GusHMeza/Tandem/README.md

# Tandem
**Xilinx ZYNQ 7000 based compute module**
Work in progress 🛠

_As the final deliverable to complete FEDEVEL: High Speed Digital Hardware Design course by instructor Phil Salmony._

Since form factor was free to chose, I picked 150x100 mm or less as a target based on a rough estimate of how big of a rectangle could fit all the components and went from there. Next, worked my way through layout with rough calculations to get a sense of interconnect length and layer distribution and finally refined the design based on detailed calculations and simulation work. 

**Compute power**

Xilinx Zynq 7000 series SoC, Part Number: 

**Comunications & Networking:**

1 X Gigabit Ethernet

1 X USB 2.0 (USB On-the-go compatible)

**Configuration**

1 X JTAG interface

**Memory**

2 X DDR Gen 3 low power (16-bit wide data bus) components

1 X 8 Gb of eMMC component

**Power** 

10W (5V) power supply

**Expansion connectors**

2 X Mezzanine connectors (break out some I/O from the Zynq 7000)

Front



Back



# Signal Integrity

**Target interconnects & requirements**

The PCB deisgn is mainly driven by the DDR Gen 3 single-ended signals and differential clocks as they have have the highest speed requirements. The selected stackup shall also accomodate a Gigabit Ethernet transciever, with 1 GHz differencial signaling, and a USB PHY close to the SoC.

| Timing Parameters |  |
| --- | --- |
| Transfer rate | 1886 MT/s |
| Clock rate | 0.9 GHz |
| Signal period | 1ns period |

| DDR drivers | | |
| --- | --- | --- |
| Static discipline | Unit/note ||
| VTT | 0.675 |V|
| Vih(ac) | 135 mV |above VTT|
| Vil(ac) | -135 mV |below VTT|
| --- | --- | --- |
| Specification | Unit ||
| C @ 1 GHz | 2 |pF|
| Over/under shoot | 0.1 |V/ns|
| Single ended slew rate max | 5 |V/ns|

| Driver output impedance | | |
| --- | --- | --- |
| Zo | Unit |Note|
| 34.3 | Ohms |Default|
| 40 | Ohms |Alternate|

**Stackup selection**

The standard 10L PCB build-up from PCB way was selected, as their overall pricing is cheap and their capabilities seem sufficient using their 'low difficulty to manufacture' specifications.



The layer assignment goes as below, and the expected characteristic impedances obtained from it were calculated using a spreadsheet and the formulae from Hall S., Hall G. and McCall J., High Speed Digital System Design, 2001, Wiley.

Layer assignment considers the DDR control signals are routed more towards the back side of the board as termination resitors are placed on the back side of the board and this layer assignment offers a logical channel architecture. The control signals are intended to have a GND plane above and below to maximize SI. 

DDR data signals are routed on the top layer to obtain faster propagation due to having no dielectric material above, as well as to allocate them sufficient space for them to fan out as needed. Routing DDR data and DDR control lines on the same layer seemed impractical as they are difficul to fan out given the current pin assignment on the CLG400 package.
  


**Loss characterization**

Two package models were developed for the Zynq 7000, one considering a generic 25 um Au wire bond on a worst case length for the 17x17mm package and another one considering 90um C4 bumps with a package via in series. An online calculator was used to approximate RLC values for these structures, and the channel was simulated in SPICE software that offest S-parameter visualization (QUCS).

1st package model (generic wire-bond package technology)



2nd package model (C4 bumps used on higher speed packages)



_Conclusion_

-For the frequency of interest for the DDR interface (1 GHz) it is not feasible to typicall wire bond technology, as it causes that the majority of the signal's energy content is reflected back to the source at the frequency of interest. 

-Assuming the Zynq 7000's package uses C4 bumps, the SPICE simulation that considers the C4 bump in series with a package via, one fan out via, the PCB trace and one last connection via shows that insertion loss is -0.498 dB and return loss is -9.659 dB.

To verify if this is a feasible design, the loss budget is calculated below.

| Loss budget | | |
| --- | --- | --- |
| Value | Unit |Note|
| 0.675 | V |VTT|
| 0.135 | V (above VTT) |Vhigh|
| 0.81 | V |Vhigh|
| 0.54 | V |Vdd-Vhigh = V_loss margin|
| -0.9691 | dB |10*log10(V_loss margin / VTT)|

On DDR the voltage fluctutates between VTT and either rail. For a HIGH bit, the voltage will fluctuate from VTT to VDD, and has to cross Vhigh (ac) specified on the data sheet for it to be on the right amplitude. Therefore, the margin between 0.81 V (VTT + 135mV) and VDD is 0.54 V. This is considered to be the loss margin, which relative to VTT (which is VDD/2) is -0.9691 dB.

Per the calculations above, singal loss @ 1 GHz is of -0.498 dB and is within the loss budget of -0.9691 dB. Assuming the IC package uses C4 bumps type packaging and the cylindrical wire model is accurate (as a solder ball after reflow becomes a truncated sphere on both sides), the singl ended channel design is feasible to transmit the DDR single ended signals. 

**Crosstalk estimations**

To account for routing density, the potential crosstalk on the traces was evaluated using the provided IBIS models for the Zynq 7000 on Xilinx's website and a series of circuit models created to simulate cross talk and cross talk induced time delays.

This is work in progress...









# Layout

DDR data signals on L1



DDR control signals on layers 6, 8 and 10.







# Signal Integrity Test Vehicles (SITV)

This project moivated me to create an SITV design to test different materials for stackups and common copper structures found in Tandem with a VNA up to the GHz range. I have a nano VNA on hand which can measure up to 1.5 GHz which is barely enough for the purpose of meausuring performance at the DDR fudamental frequency. Version 1 of the SITV was designed to cover the test cases below. All of the structures are non-impedance-controlled and are the minimum size copper features offered by JLCPCB.

| Test cases | | |
| --- | --- | --- |
| Description | Results |P/F|
| Insertion loss of a 30 mm straight trace | dB | TBD |
| Delta L test to measure loss purely due to the PCB trace | dB/in | TBD |
| Via transitions: compare loss between 1 transition and 2 transitions | dB | TBD |
| Crosstalk test, spacing 1: compare voltage amplitude on the victim trace at different trace spacings | dB @ f _ spacing 1 | TBD |
| Crosstalk test, spacing 2 | dB @ f _ spacing 2 | TBD |
| Straight trace insertion loss vs skewed trace insertion loss | dB @ 1° and 5° skew | TBD |

Work in progress...



For instance, this picture below shows that this non-impedance-controlled structure causes -2.7 dB of loss at 450 MHz and above 600 MHz there is more energy being reflected back to source than proagating through it. Therefore, for a loss budget of around 2 dB, it shows that the maximum allowable frequency for such a structure is 400 MHz. The following version of the SITV will expand on these type of measurements and results are to be reported with mention of the stack up materials. 



Version 2 of the SITV includes more carefully designed test cases and the capability to establish the VNA reference plane right at the PCB using on-board SOLT calibration structures. Moreover, all copper sturctures were designed to have Zo = 50 Ohms.

Version 2 test cases are as below.

| Test cases | | |
| --- | --- | --- |
| Description | Results |P/F|
| Impedance of a straight copper trace (designed to be 50 Ohms) | Smith chart normalized to 50 Ohms | TBD |
| Delta L test to measure loss purely due to the PCB trace | dB/in | TBD |
| Via transitions: compare loss between 1 transition and 2 transitions | dB | TBD |
| Crosstalk test: compare voltage amplitude on the victim trace at minimum trace spacing | dB @ different frequencies | TBD |
| Insertion loss on the presence of stubs: noitice the effect of multiple different length stubs on the same trace | TDR measurement | TBD |
| Serpentine mismatch: notice which serpentine structure causes the most impedance mismatch | TDR measurement | TBD |
