GusHMeza/Tandem/Conf_Jtag_Dbg.kicad_sch

## KiCad design Conf_Jtag_Dbg.kicad_sch (2026-02-01)

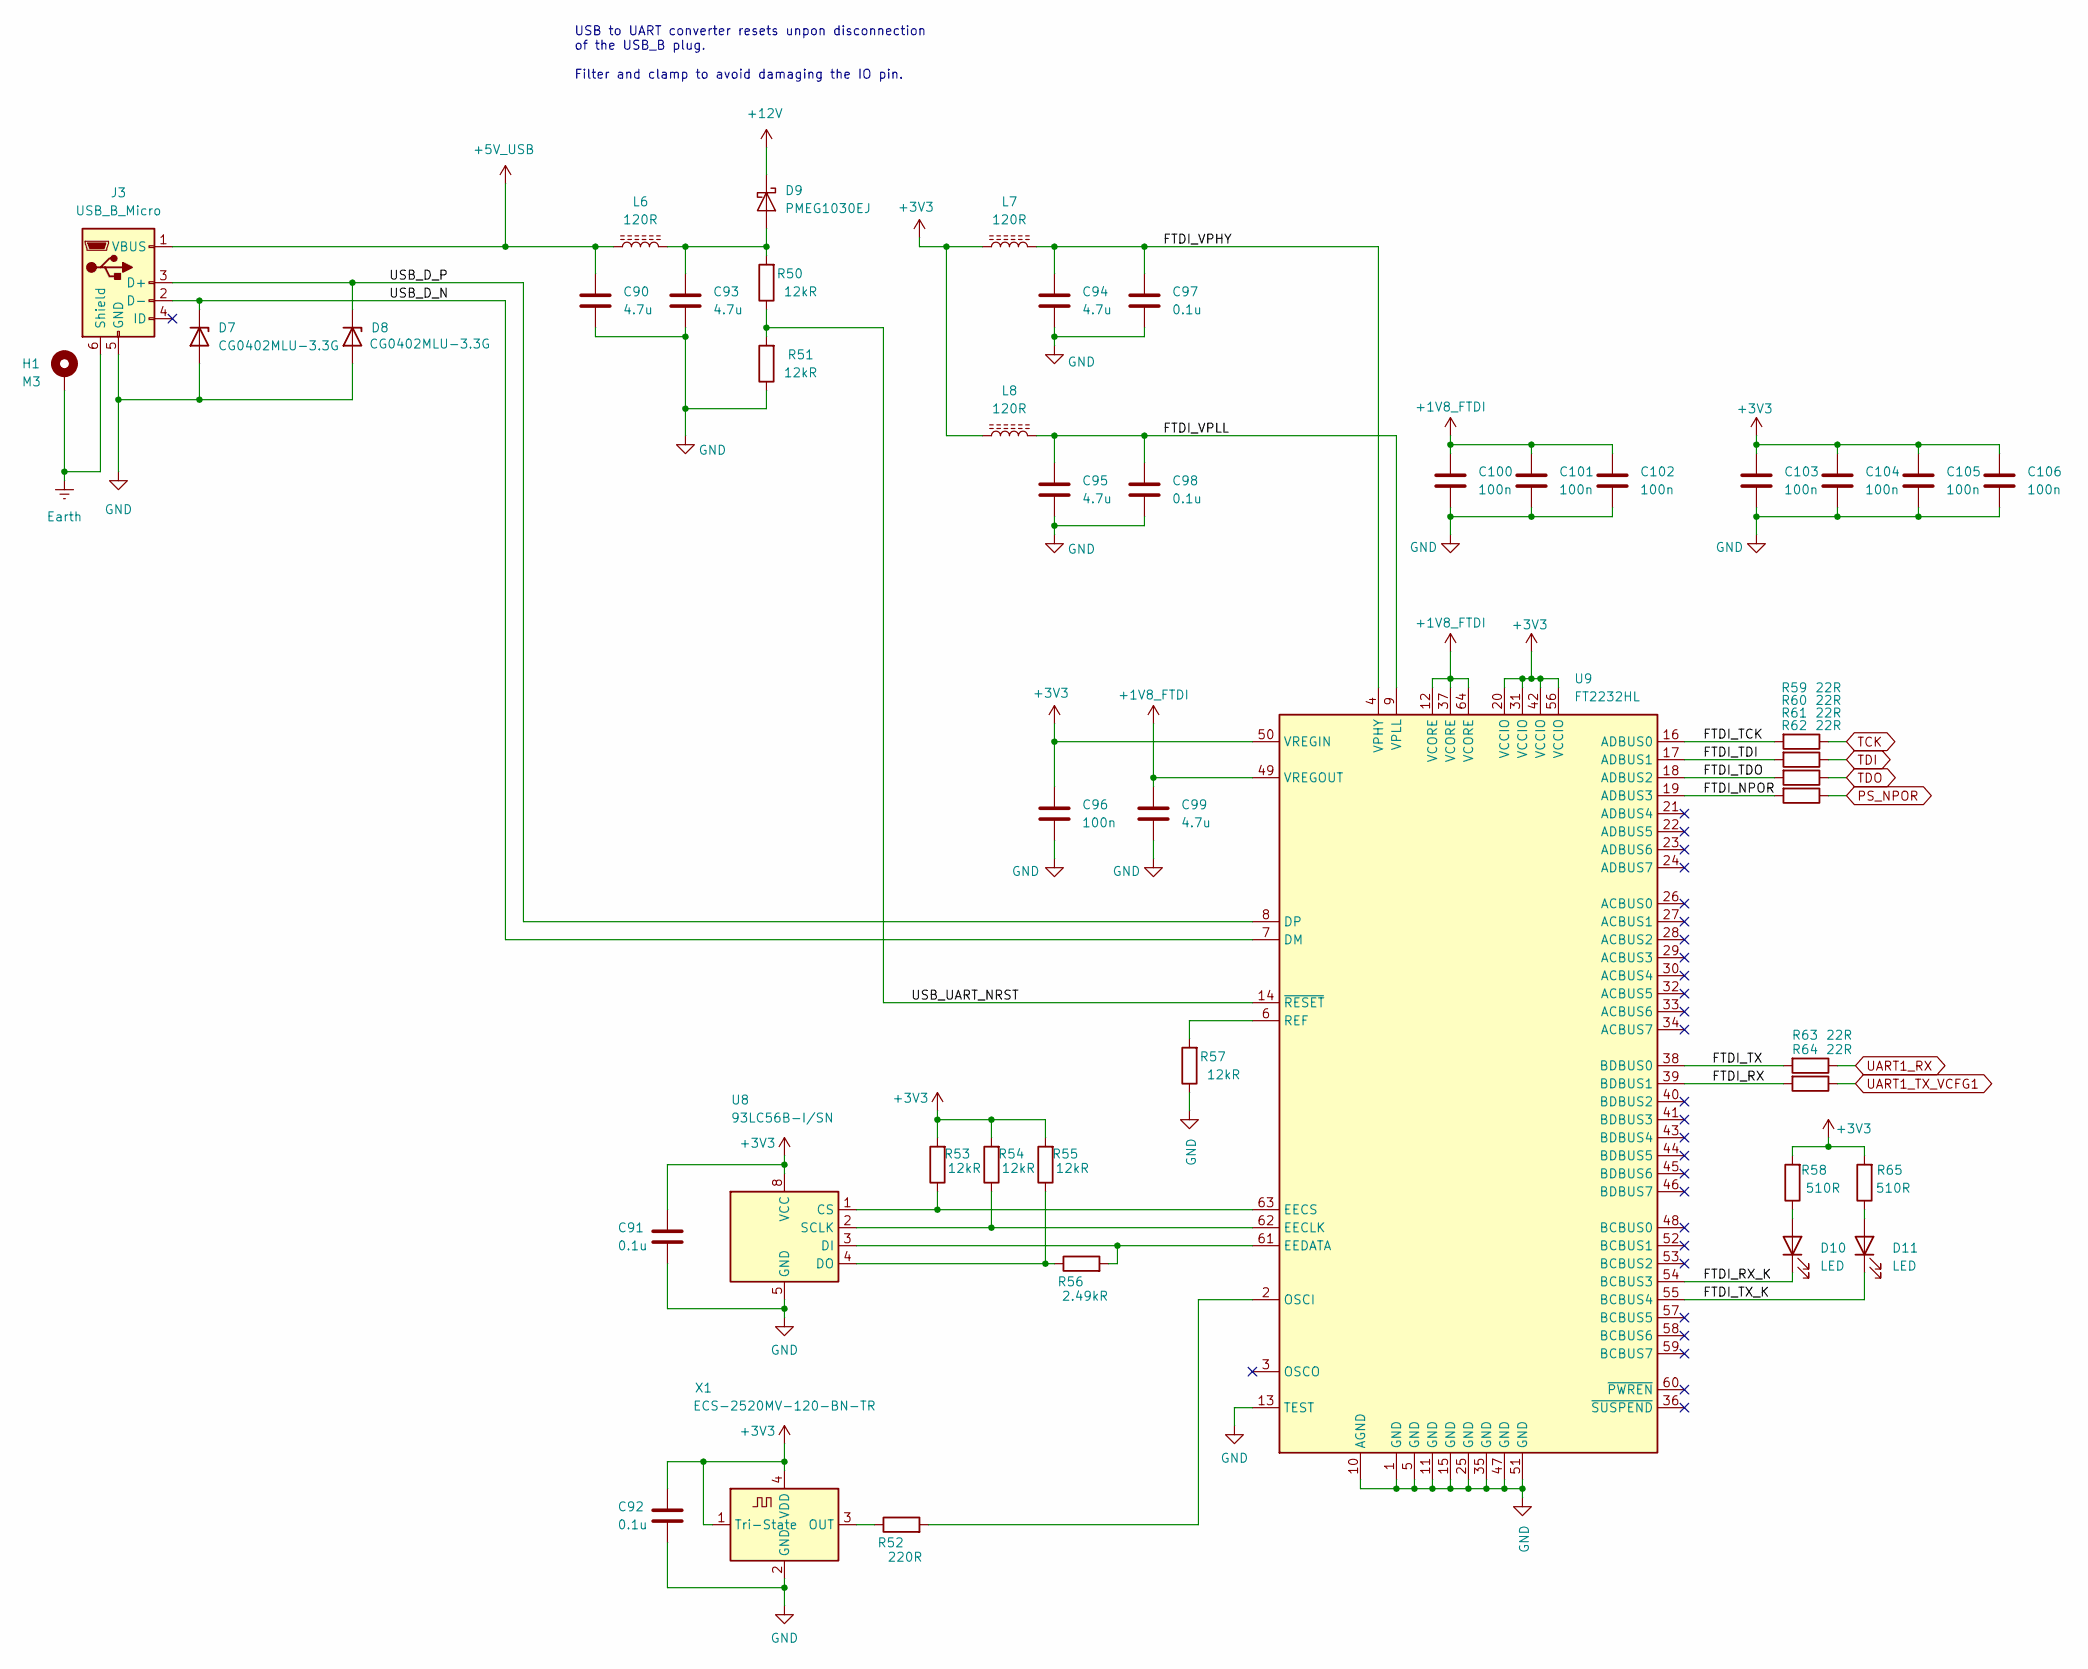
[picture p1: schematic Conf_Jtag_Dbg.kicad_sch]

Parts:
C90, C93, C94, C95, C99: 4.7u; C_0201_0603Metric
C91, C92, C97, C98: 0.1u; C_0201_0603Metric
C96, C100, C101, C102, C103, C104, C105, C106: 100n; C_0201_0603Metric
D7, D8: CG0402MLU-3.3G; D_0402_1005Metric
D9: PMEG1030EJ; D_SOD-323F
D10, D11: LED; D_0603_1608Metric
H1: M3; MountingHole_2.7mm_M2.5_DIN965_Pad
J3: USB_B_Micro; USB_Micro-B_Molex_47346-0001
L6, L7, L8: 120R; L_0402_1005Metric
R50, R51, R53, R54, R55, R57: 12kR; R_0402_1005Metric_Pad0.72x0.64mm_HandSolder
R52: 220R; R_0402_1005Metric_Pad0.72x0.64mm_HandSolder
R56: 2.49kR; R_0402_1005Metric_Pad0.72x0.64mm_HandSolder
R58, R65: 510R; R_0402_1005Metric_Pad0.72x0.64mm_HandSolder
R59, R60, R61, R62, R63, R64: 22R; R_0402_1005Metric_Pad0.72x0.64mm_HandSolder
U8: 93LC56B-I/SN; SOIC-8_3.9x4.9mm_P1.27mm
U9: FT2232HL; LQFP-64_10x10mm_P0.5mm
X1: ECS-2520MV-120-BN-TR; Oscillator_SMD_ECS_2520MV-xxx-xx-4Pin_2.5x2.0mm

Connections:
+1V8_FTDI: C99.1, C100.1, C101.1, C102.1, U9.12 (VCORE), U9.37 (VCORE), U9.49 (VREGOUT), U9.64 (VCORE)
+3V3: C91.1, C92.1, C96.1, C103.1, C104.1, C105.1, C106.1, L7.1, L8.1, R53.2, R54.2, R55.2, R58.2, R65.2, U8.8 (VCC), U9.20 (VCCIO), U9.31 (VCCIO), U9.42 (VCCIO), U9.50 (VREGIN), U9.56 (VCCIO), X1.1 (Tri-State), X1.4 (VDD)
+5V_USB: C90.1, J3.1 (VBUS), L6.1
+12V: D9.1 (K)
Earth: H1.1, J3.6 (Shield)
FTDI_NPOR: R62.2, U9.19 (ADBUS3)
FTDI_RX: R64.2, U9.39 (BDBUS1)
FTDI_RX_K: D10.1 (K), U9.54 (BCBUS3)
FTDI_TCK: R59.2, U9.16 (ADBUS0)
FTDI_TDI: R60.2, U9.17 (ADBUS1)
FTDI_TDO: R61.2, U9.18 (ADBUS2)
FTDI_TX: R63.2, U9.38 (BDBUS0)
FTDI_TX_K: D11.1 (K), U9.55 (BCBUS4)
FTDI_VPHY: C94.1, C97.1, L7.2, U9.4 (VPHY)
FTDI_VPLL: C95.1, C98.1, L8.2, U9.9 (VPLL)
GND: C90.2, C91.2, C92.2, C93.2, C94.2, C95.2, C96.2, C97.2, C98.2, C99.2, C100.2, C101.2, C102.2, C103.2, C104.2, C105.2, C106.2, D7.2 (A), D8.2 (A), J3.5 (GND), R51.1, R57.1, U8.5 (GND), U9.1 (GND), U9.5 (GND), U9.10 (AGND), U9.11 (GND), U9.13 (TEST), U9.15 (GND), U9.25 (GND), U9.35 (GND), U9.47 (GND), U9.51 (GND), X1.2 (GND)
unnamed: C93.1, D9.2 (A), L6.2, R50.2
unnamed: D10.2 (A), R58.1
unnamed: D11.2 (A), R65.1
unnamed: R52.1, X1.3 (OUT)
unnamed: R52.2, U9.2 (OSCI)
unnamed: R53.1, U8.1 (CS), U9.63 (EECS)
unnamed: R54.1, U8.2 (SCLK), U9.62 (EECLK)
unnamed: R55.1, R56.1, U8.4 (DO)
unnamed: R56.2, U8.3 (DI), U9.61 (EEDATA)
unnamed: R57.2, U9.6 (REF)
PS_NPOR: R62.1
TCK: R59.1
TDI: R60.1
TDO: R61.1
UART1_RX: R63.1
UART1_TX_VCFG1: R64.1
USB_D_N: D7.1 (K), J3.2 (D-), U9.7 (DM)
USB_D_P: D8.1 (K), J3.3 (D+), U9.8 (DP)
USB_UART_NRST: R50.1, R51.2, U9.14 (~RESET)

Notes on the sheet:
USB to UART converter resets unpon disconnection of the USB_B plug. Filter and clamp to avoid damaging the IO pin.
