GusHMeza/Tandem/DDR_term.kicad_sch

## KiCad design DDR_term.kicad_sch (2026-02-01)

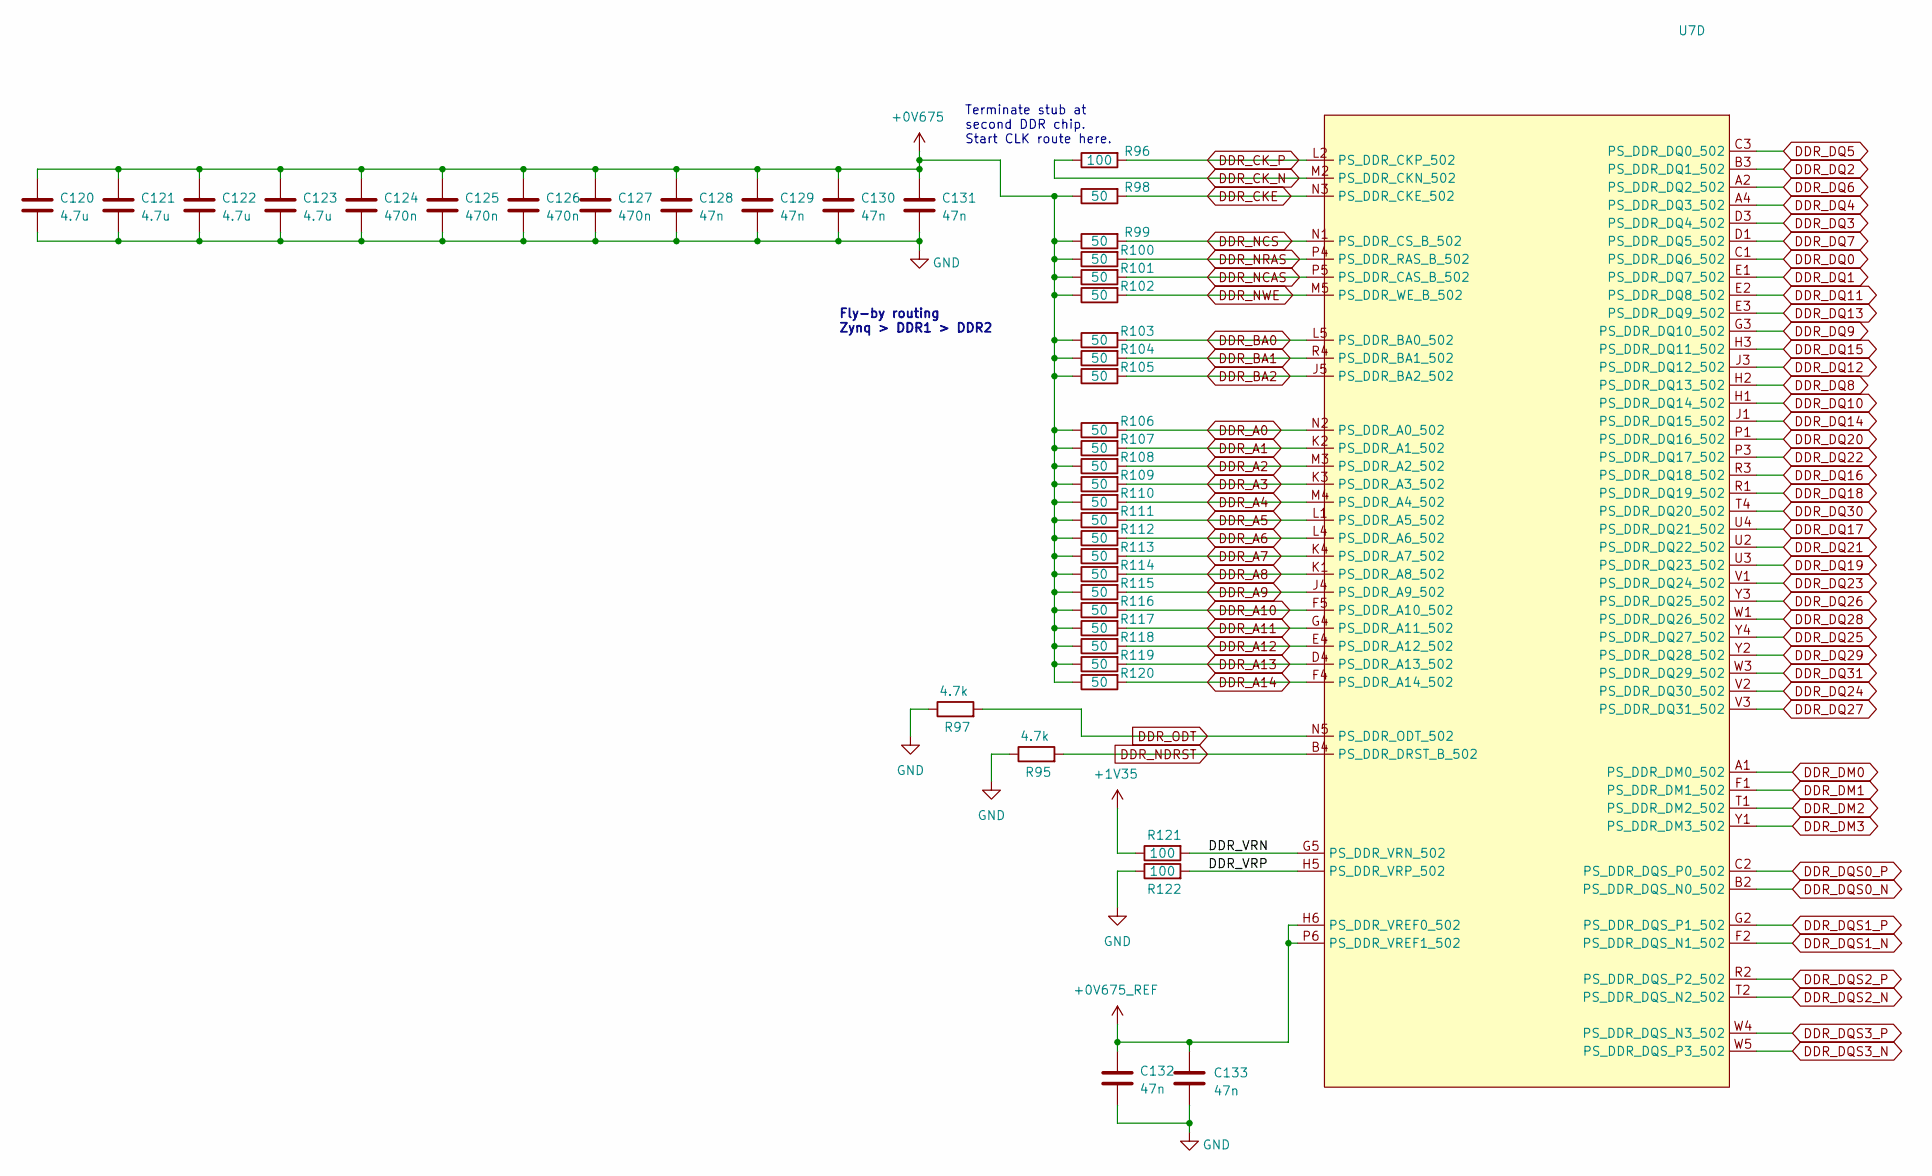
[picture p3: schematic DDR_term.kicad_sch]

Parts:
C120, C121, C122, C123: 4.7u; C_0201_0603Metric
C124, C125, C126, C127: 470n; C_0201_0603Metric
C128, C129, C130, C131, C132, C133: 47n; C_0201_0603Metric
R95, R97: 4.7k; R_0402_1005Metric_Pad0.72x0.64mm_HandSolder
R96, R121, R122: 100; R_0402_1005Metric_Pad0.72x0.64mm_HandSolder
R98, R99, R100, R101, R102, R103, R104, R105, R106, R107, R108, R109, R110, R111, R112, R113, R114, R115, R116, R117, R118, R119, R120: 50; R_0402_1005Metric_Pad0.72x0.64mm_HandSolder
U7: Xilinx_CLG400

Connections:
+0V675: C120.1, C121.1, C122.1, C123.1, C124.1, C125.1, C126.1, C127.1, C128.1, C129.1, C130.1, C131.1, R98.1, R99.1, R100.1, R101.1, R102.1, R103.1, R104.1, R105.1, R106.1, R107.1, R108.1, R109.1, R110.1, R111.1, R112.1, R113.1, R114.1, R115.1, R116.1, R117.1, R118.1, R119.1, R120.1
+0V675_REF: C132.1, C133.1, U7.H6 (PS_DDR_VREF0_502), U7.P6 (PS_DDR_VREF1_502)
+1V35: R121.1
DDR_A0: R106.2, U7.N2 (PS_DDR_A0_502)
DDR_A1: R107.2, U7.K2 (PS_DDR_A1_502)
DDR_A2: R108.2, U7.M3 (PS_DDR_A2_502)
DDR_A3: R109.2, U7.K3 (PS_DDR_A3_502)
DDR_A4: R110.2, U7.M4 (PS_DDR_A4_502)
DDR_A5: R111.2, U7.L1 (PS_DDR_A5_502)
DDR_A6: R112.2, U7.L4 (PS_DDR_A6_502)
DDR_A7: R113.2, U7.K4 (PS_DDR_A7_502)
DDR_A8: R114.2, U7.K1 (PS_DDR_A8_502)
DDR_A9: R115.2, U7.J4 (PS_DDR_A9_502)
DDR_A10: R116.2, U7.F5 (PS_DDR_A10_502)
DDR_A11: R117.2, U7.G4 (PS_DDR_A11_502)
DDR_A12: R118.2, U7.E4 (PS_DDR_A12_502)
DDR_A13: R119.2, U7.D4 (PS_DDR_A13_502)
DDR_A14: R120.2, U7.F4 (PS_DDR_A14_502)
DDR_BA0: R103.2, U7.L5 (PS_DDR_BA0_502)
DDR_BA1: R104.2, U7.R4 (PS_DDR_BA1_502)
DDR_BA2: R105.2, U7.J5 (PS_DDR_BA2_502)
DDR_CKE: R98.2, U7.N3 (PS_DDR_CKE_502)
DDR_CK_N: R96.1, U7.M2 (PS_DDR_CKN_502)
DDR_CK_P: R96.2, U7.L2 (PS_DDR_CKP_502)
DDR_DM0: U7.A1 (PS_DDR_DM0_502)
DDR_DM1: U7.F1 (PS_DDR_DM1_502)
DDR_DM2: U7.T1 (PS_DDR_DM2_502)
DDR_DM3: U7.Y1 (PS_DDR_DM3_502)
DDR_DQ0: U7.C1 (PS_DDR_DQ6_502)
DDR_DQ1: U7.E1 (PS_DDR_DQ7_502)
DDR_DQ2: U7.B3 (PS_DDR_DQ1_502)
DDR_DQ3: U7.D3 (PS_DDR_DQ4_502)
DDR_DQ4: U7.A4 (PS_DDR_DQ3_502)
DDR_DQ5: U7.C3 (PS_DDR_DQ0_502)
DDR_DQ6: U7.A2 (PS_DDR_DQ2_502)
DDR_DQ7: U7.D1 (PS_DDR_DQ5_502)
DDR_DQ8: U7.H2 (PS_DDR_DQ13_502)
DDR_DQ9: U7.G3 (PS_DDR_DQ10_502)
DDR_DQ10: U7.H1 (PS_DDR_DQ14_502)
DDR_DQ11: U7.E2 (PS_DDR_DQ8_502)
DDR_DQ12: U7.J3 (PS_DDR_DQ12_502)
DDR_DQ13: U7.E3 (PS_DDR_DQ9_502)
DDR_DQ14: U7.J1 (PS_DDR_DQ15_502)
DDR_DQ15: U7.H3 (PS_DDR_DQ11_502)
DDR_DQ16: U7.R3 (PS_DDR_DQ18_502)
DDR_DQ17: U7.U4 (PS_DDR_DQ21_502)
DDR_DQ18: U7.R1 (PS_DDR_DQ19_502)
DDR_DQ19: U7.U3 (PS_DDR_DQ23_502)
DDR_DQ20: U7.P1 (PS_DDR_DQ16_502)
DDR_DQ21: U7.U2 (PS_DDR_DQ22_502)
DDR_DQ22: U7.P3 (PS_DDR_DQ17_502)
DDR_DQ23: U7.V1 (PS_DDR_DQ24_502)
DDR_DQ24: U7.V2 (PS_DDR_DQ30_502)
DDR_DQ25: U7.Y4 (PS_DDR_DQ27_502)
DDR_DQ26: U7.Y3 (PS_DDR_DQ25_502)
DDR_DQ27: U7.V3 (PS_DDR_DQ31_502)
DDR_DQ28: U7.W1 (PS_DDR_DQ26_502)
DDR_DQ29: U7.Y2 (PS_DDR_DQ28_502)
DDR_DQ30: U7.T4 (PS_DDR_DQ20_502)
DDR_DQ31: U7.W3 (PS_DDR_DQ29_502)
DDR_DQS0_N: U7.B2 (PS_DDR_DQS_N0_502)
DDR_DQS0_P: U7.C2 (PS_DDR_DQS_P0_502)
DDR_DQS1_N: U7.F2 (PS_DDR_DQS_N1_502)
DDR_DQS1_P: U7.G2 (PS_DDR_DQS_P1_502)
DDR_DQS2_N: U7.T2 (PS_DDR_DQS_N2_502)
DDR_DQS2_P: U7.R2 (PS_DDR_DQS_P2_502)
DDR_DQS3_N: U7.W5 (PS_DDR_DQS_P3_502)
DDR_DQS3_P: U7.W4 (PS_DDR_DQS_N3_502)
DDR_NCAS: R101.2, U7.P5 (PS_DDR_CAS_B_502)
DDR_NCS: R99.2, U7.N1 (PS_DDR_CS_B_502)
DDR_NDRST: R95.2, U7.B4 (PS_DDR_DRST_B_502)
DDR_NRAS: R100.2, U7.P4 (PS_DDR_RAS_B_502)
DDR_NWE: R102.2, U7.M5 (PS_DDR_WE_B_502)
DDR_ODT: R97.2, U7.N5 (PS_DDR_ODT_502)
DDR_VRN: R121.2, U7.G5 (PS_DDR_VRN_502)
DDR_VRP: R122.2, U7.H5 (PS_DDR_VRP_502)
GND: C120.2, C121.2, C122.2, C123.2, C124.2, C125.2, C126.2, C127.2, C128.2, C129.2, C130.2, C131.2, C132.2, C133.2, R95.1, R97.1, R122.1

Notes on the sheet:
Terminate stub at second DDR chip. Start CLK route here.
Fly-by routing Zynq > DDR1 > DDR2
