GusHMeza/Tandem/GB_Eth.kicad_sch

## KiCad design GB_Eth.kicad_sch (2026-02-01)

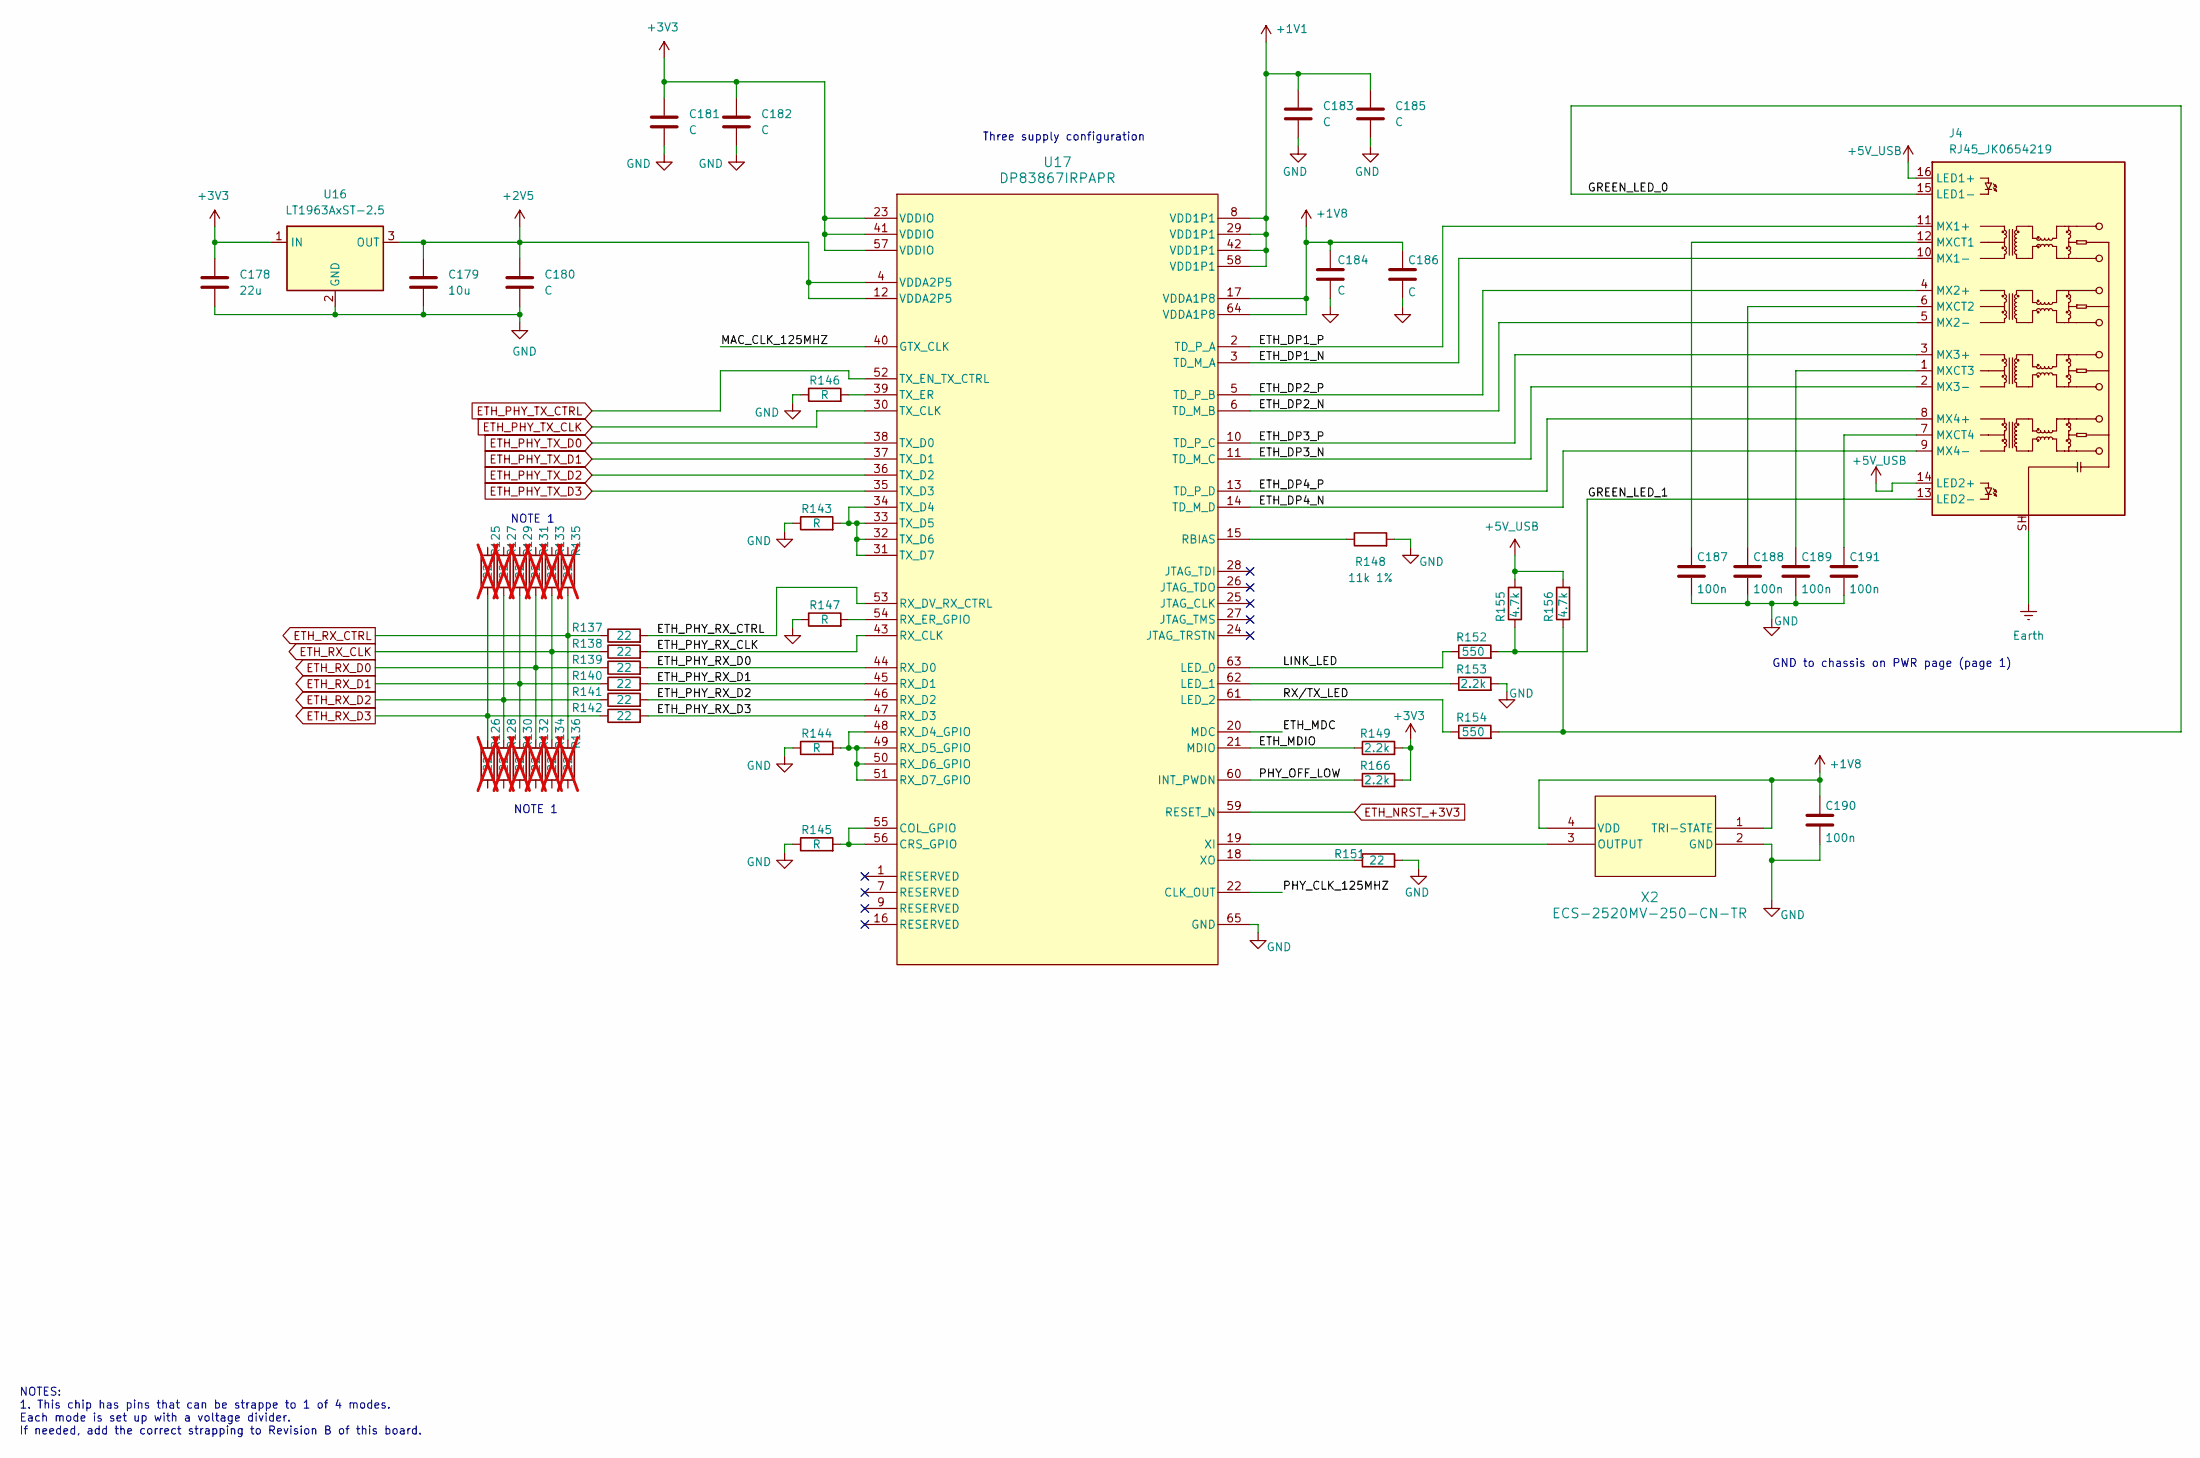
[picture p4: schematic GB_Eth.kicad_sch]

Parts:
C178: 22u; C_0201_0603Metric
C179: 10u; C_0201_0603Metric
C180, C181, C182, C183, C184, C185, C186: C; C_0201_0603Metric
C187, C188, C189, C190, C191: 100n; C_0201_0603Metric
J4: RJ45_JK0654219; RJ45_Pulse_JK0654219NL_Horizontal
R125, R126, R127, R128, R129, R130, R131, R132, R133, R134, R135, R136: 22; R_0402_1005Metric_Pad0.72x0.64mm_HandSolder; not fitted
R137, R138, R139, R140, R141, R142, R151: 22; R_0402_1005Metric_Pad0.72x0.64mm_HandSolder
R143, R144, R145, R146, R147: R; R_0402_1005Metric_Pad0.72x0.64mm_HandSolder
R148: 11k 1%; R_0402_1005Metric_Pad0.72x0.64mm_HandSolder
R149, R153, R166: 2.2k; R_0402_1005Metric_Pad0.72x0.64mm_HandSolder
R152, R154: 550; R_0402_1005Metric_Pad0.72x0.64mm_HandSolder
R155, R156: 4.7k; R_0402_1005Metric_Pad0.72x0.64mm_HandSolder
U16: LT1963AxST-2.5; SOT-223-3_TabPin2
U17: DP83867IRPAPR; PAP0064M_L
X2: ECS-2520MV-250-CN-TR; OSC_ECS-2520MV_ECS

Connections:
+1V1: C183.1, C185.1, U17.8 (VDD1P1), U17.29 (VDD1P1), U17.42 (VDD1P1), U17.58 (VDD1P1)
+1V8: C184.1, C186.1, C190.1, U17.17 (VDDA1P8), U17.64 (VDDA1P8), X2.1 (TRI-STATE), X2.4 (VDD)
+2V5: C179.1, C180.1, U16.3 (OUT), U17.4 (VDDA2P5), U17.12 (VDDA2P5)
+3V3: C178.1, C181.1, C182.1, R149.2, R166.2, U16.1 (IN), U17.23 (VDDIO), U17.41 (VDDIO), U17.57 (VDDIO)
+5V_USB: J4.14 (LED2+), J4.16 (LED1+), R155.2, R156.2
ETH_DP1_N: J4.10 (MX1-), U17.3 (TD_M_A)
ETH_DP1_P: J4.11 (MX1+), U17.2 (TD_P_A)
ETH_DP2_N: J4.5 (MX2-), U17.6 (TD_M_B)
ETH_DP2_P: J4.4 (MX2+), U17.5 (TD_P_B)
ETH_DP3_N: J4.2 (MX3-), U17.11 (TD_M_C)
ETH_DP3_P: J4.3 (MX3+), U17.10 (TD_P_C)
ETH_DP4_N: J4.9 (MX4-), U17.14 (TD_M_D)
ETH_DP4_P: J4.8 (MX4+), U17.13 (TD_P_D)
ETH_MDC: U17.20 (MDC)
ETH_MDIO: R149.1, U17.21 (MDIO)
ETH_NRST_+3V3: U17.59 (RESET_N)
ETH_PHY_RX_CLK: R138.2, U17.43 (RX_CLK)
ETH_PHY_RX_CTRL: R137.2, U17.53 (RX_DV_RX_CTRL)
ETH_PHY_RX_D0: R139.2, U17.44 (RX_D0)
ETH_PHY_RX_D1: R140.2, U17.45 (RX_D1)
ETH_PHY_RX_D2: R141.2, U17.46 (RX_D2)
ETH_PHY_RX_D3: R142.2, U17.47 (RX_D3)
ETH_PHY_TX_CLK: U17.30 (TX_CLK)
ETH_PHY_TX_CTRL: U17.52 (TX_EN_TX_CTRL)
ETH_PHY_TX_D0: U17.38 (TX_D0)
ETH_PHY_TX_D1: U17.37 (TX_D1)
ETH_PHY_TX_D2: U17.36 (TX_D2)
ETH_PHY_TX_D3: U17.35 (TX_D3)
ETH_RX_CLK: R133.1, R134.2, R138.1
ETH_RX_CTRL: R135.1, R136.2, R137.1
ETH_RX_D0: R131.1, R132.2, R139.1
ETH_RX_D1: R129.1, R130.2, R140.1
ETH_RX_D2: R127.1, R128.2, R141.1
ETH_RX_D3: R125.1, R126.2, R142.1
Earth: J4.SH
GND: C178.2, C179.2, C180.2, C181.2, C182.2, C183.2, C184.2, C185.2, C186.2, C187.2, C188.2, C189.2, C190.2, C191.2, R143.1, R144.1, R145.1, R146.1, R147.1, R148.2, R151.2, R153.2, U16.2 (GND), U17.65 (GND), X2.2 (GND)
GREEN_LED_0: J4.15 (LED1-), R154.2, R156.1
GREEN_LED_1: J4.13 (LED2-), R152.2, R155.1
LINK_LED: R152.1, U17.63 (LED_0)
MAC_CLK_125MHZ: U17.40 (GTX_CLK)
unnamed: C187.1, J4.12 (MXCT1)
unnamed: C188.1, J4.6 (MXCT2)
unnamed: C189.1, J4.1 (MXCT3)
unnamed: C191.1, J4.7 (MXCT4)
unnamed: R143.2, U17.31 (TX_D7), U17.32 (TX_D6), U17.33 (TX_D5), U17.34 (TX_D4)
unnamed: R144.2, U17.48 (RX_D4_GPIO), U17.49 (RX_D5_GPIO), U17.50 (RX_D6_GPIO), U17.51 (RX_D7_GPIO)
unnamed: R145.2, U17.55 (COL_GPIO), U17.56 (CRS_GPIO)
unnamed: R146.2, U17.39 (TX_ER)
unnamed: R147.2, U17.54 (RX_ER_GPIO)
unnamed: R148.1, U17.15 (RBIAS)
unnamed: R151.1, U17.18 (XO)
unnamed: R153.1, U17.62 (LED_1)
unnamed: U17.19 (XI), X2.3 (OUTPUT)
PHY_CLK_125MHZ: U17.22 (CLK_OUT)
PHY_OFF_LOW: R166.1, U17.60 (INT_PWDN)
RX/TX_LED: R154.1, U17.61 (LED_2)

Notes on the sheet:
NOTES: 1. This chip has pins that can be strappe to 1 of 4 modes. Each mode is set up with a voltage divider. If needed, add the correct strapping to Revision B of this board.
NOTE 1
Three supply configuration
GND to chassis on PWR page (page 1)
