GusHMeza/Tandem/PWR_and_caps.kicad_sch

## KiCad design PWR_and_caps.kicad_sch (2026-02-01)

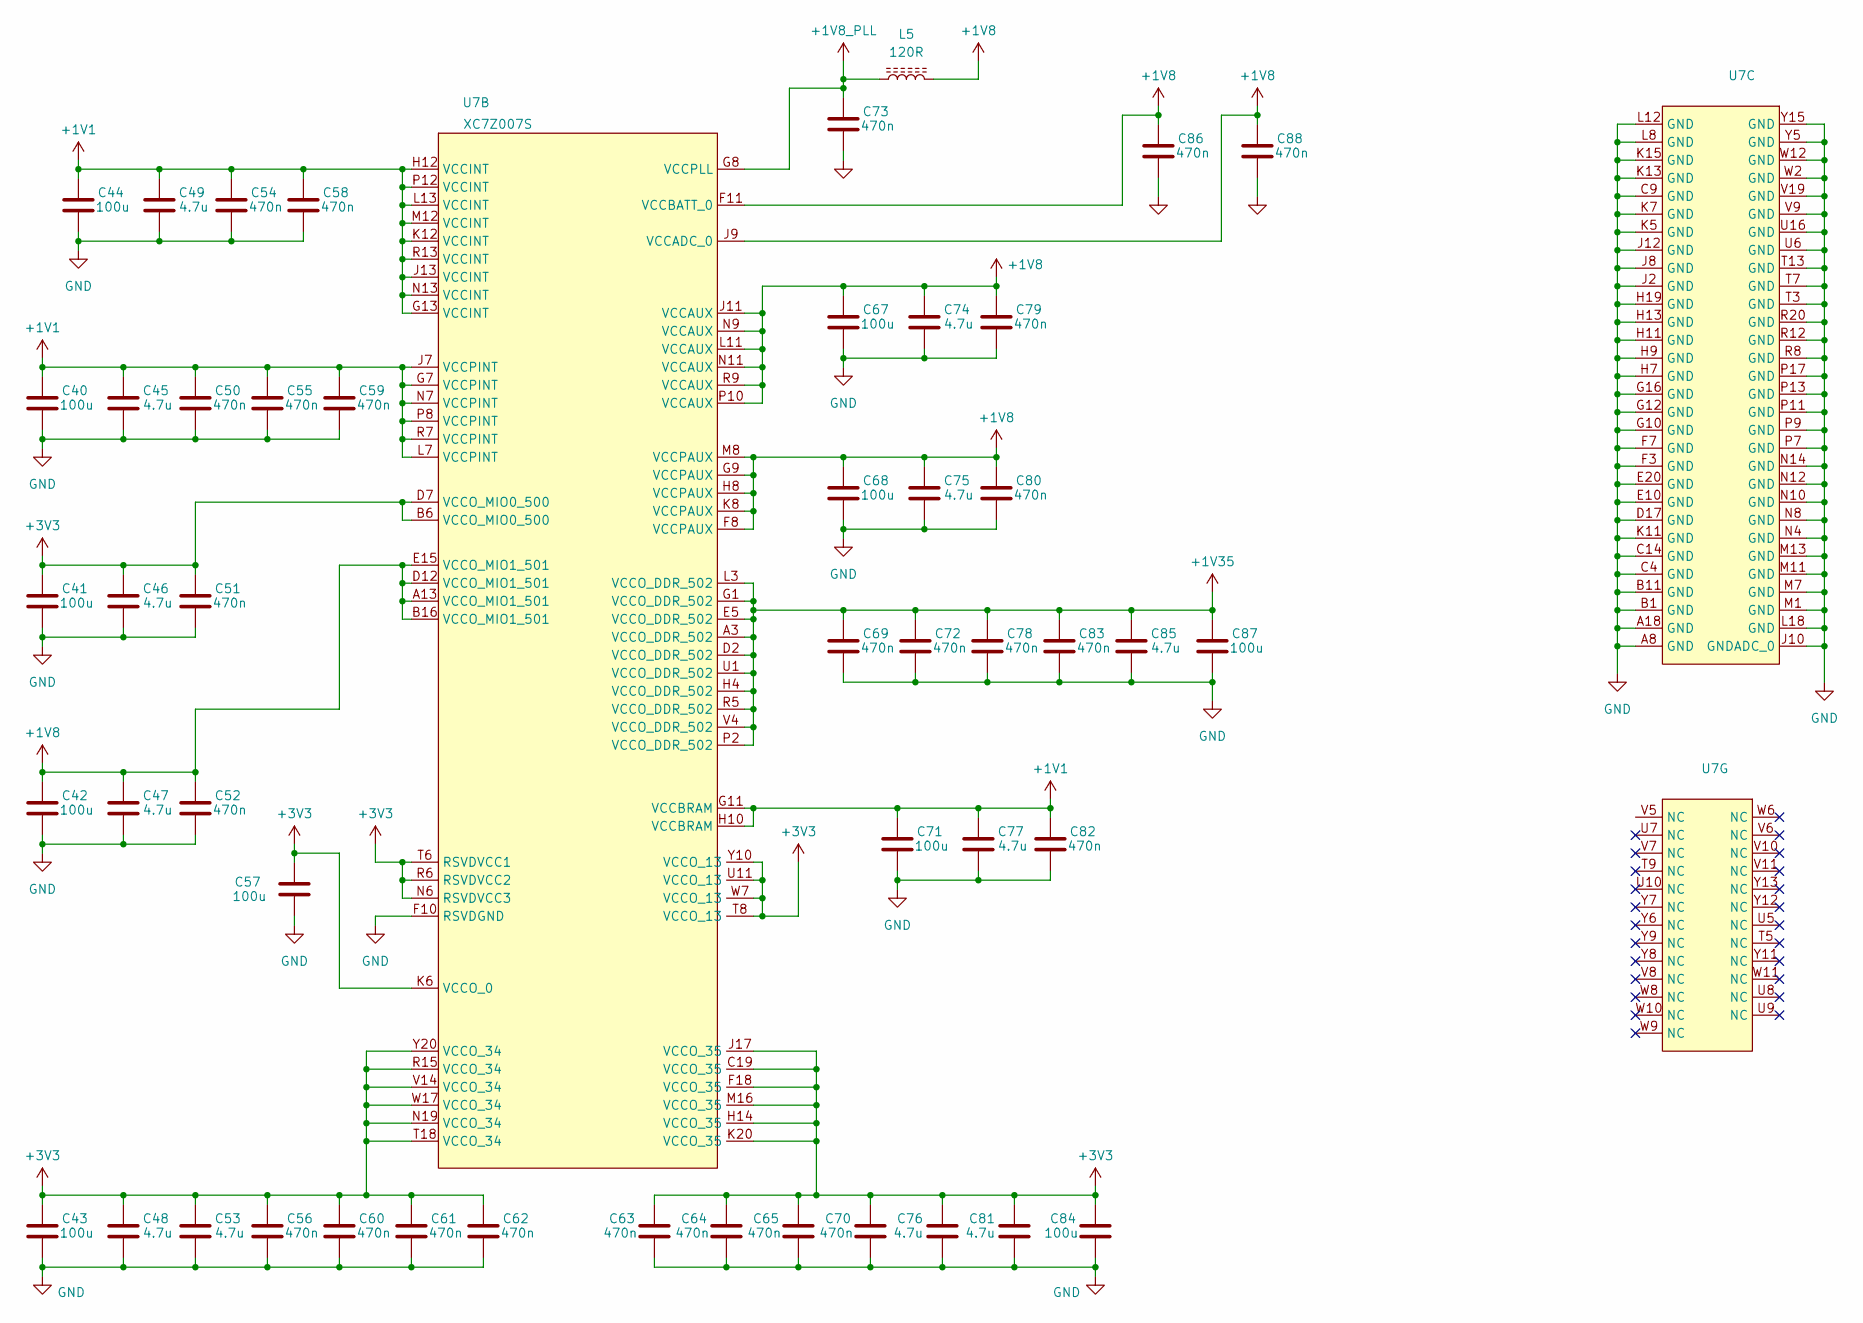
[picture p6: schematic PWR_and_caps.kicad_sch]

Parts:
C40, C41, C42, C43, C44, C57, C67, C68, C71, C84, C87: 100u; C_0201_0603Metric
C45, C46, C47, C48, C49, C53, C74, C75, C76, C77, C81, C85: 4.7u; C_0201_0603Metric
C50, C51, C52, C54, C55, C56, C58, C59, C60, C61, C62, C63, C64, C65, C69, C70, C72, C73, C78, C79, C80, C82, C83, C86, C88: 470n; C_0201_0603Metric
L5: 120R; L_0402_1005Metric
U7: Xilinx_CLG400

Connections:
+1V1: C40.2, C44.2, C45.2, C49.2, C50.2, C54.2, C55.2, C58.2, C59.2, C71.2, C77.2, C82.2, U7.G7 (VCCPINT), U7.G11 (VCCBRAM), U7.G13 (VCCINT), U7.H10 (VCCBRAM), U7.H12 (VCCINT), U7.J7 (VCCPINT), U7.J13 (VCCINT), U7.K12 (VCCINT), U7.L7 (VCCPINT), U7.L13 (VCCINT), U7.M12 (VCCINT), U7.N7 (VCCPINT), U7.N13 (VCCINT), U7.P8 (VCCPINT), U7.P12 (VCCINT), U7.R7 (VCCPINT), U7.R13 (VCCINT)
+1V8: C42.2, C47.2, C52.2, C67.2, C68.2, C74.2, C75.2, C79.2, C80.2, C86.2, C88.2, L5.1, U7.A13 (VCCO_MIO1_501), U7.B16 (VCCO_MIO1_501), U7.D12 (VCCO_MIO1_501), U7.E15 (VCCO_MIO1_501), U7.F8 (VCCPAUX), U7.F11 (VCCBATT_0), U7.G9 (VCCPAUX), U7.H8 (VCCPAUX), U7.J9 (VCCADC_0), U7.J11 (VCCAUX), U7.K8 (VCCPAUX), U7.L11 (VCCAUX), U7.M8 (VCCPAUX), U7.N9 (VCCAUX), U7.N11 (VCCAUX), U7.P10 (VCCAUX), U7.R9 (VCCAUX)
+1V8_PLL: C73.2, L5.2, U7.G8 (VCCPLL)
+1V35: C69.2, C72.2, C78.2, C83.2, C85.2, C87.2, U7.A3 (VCCO_DDR_502), U7.D2 (VCCO_DDR_502), U7.E5 (VCCO_DDR_502), U7.G1 (VCCO_DDR_502), U7.H4 (VCCO_DDR_502), U7.L3 (VCCO_DDR_502), U7.P2 (VCCO_DDR_502), U7.R5 (VCCO_DDR_502), U7.U1 (VCCO_DDR_502), U7.V4 (VCCO_DDR_502)
+3V3: C41.2, C43.2, C46.2, C48.2, C51.2, C53.2, C56.2, C57.2, C60.2, C61.2, C62.2, C63.2, C64.2, C65.2, C70.2, C76.2, C81.2, C84.2, U7.B6 (VCCO_MIO0_500), U7.C19 (VCCO_35), U7.D7 (VCCO_MIO0_500), U7.F18 (VCCO_35), U7.H14 (VCCO_35), U7.J17 (VCCO_35), U7.K6 (VCCO_0), U7.K20 (VCCO_35), U7.M16 (VCCO_35), U7.N6 (RSVDVCC3), U7.N19 (VCCO_34), U7.R6 (RSVDVCC2), U7.R15 (VCCO_34), U7.T6 (RSVDVCC1), U7.T8 (VCCO_13), U7.T18 (VCCO_34), U7.U11 (VCCO_13), U7.V14 (VCCO_34), U7.W7 (VCCO_13), U7.W17 (VCCO_34), U7.Y10 (VCCO_13), U7.Y20 (VCCO_34)
GND: C40.1, C41.1, C42.1, C43.1, C44.1, C45.1, C46.1, C47.1, C48.1, C49.1, C50.1, C51.1, C52.1, C53.1, C54.1, C55.1, C56.1, C57.1, C58.1, C59.1, C60.1, C61.1, C62.1, C63.1, C64.1, C65.1, C67.1, C68.1, C69.1, C70.1, C71.1, C72.1, C73.1, C74.1, C75.1, C76.1, C77.1, C78.1, C79.1, C80.1, C81.1, C82.1, C83.1, C84.1, C85.1, C86.1, C87.1, C88.1, U7.A8 (GND), U7.A18 (GND), U7.B1 (GND), U7.B11 (GND), U7.C4 (GND), U7.C9 (GND), U7.C14 (GND), U7.D17 (GND), U7.E10 (GND), U7.E20 (GND), U7.F3 (GND), U7.F7 (GND), U7.F10 (RSVDGND), U7.G10 (GND), U7.G12 (GND), U7.G16 (GND), U7.H7 (GND), U7.H9 (GND), U7.H11 (GND), U7.H13 (GND), U7.H19 (GND), U7.J2 (GND), U7.J8 (GND), U7.J10 (GNDADC_0), U7.J12 (GND), U7.K5 (GND), U7.K7 (GND), U7.K11 (GND), U7.K13 (GND), U7.K15 (GND), U7.L8 (GND), U7.L12 (GND), U7.L18 (GND), U7.M1 (GND), U7.M7 (GND), U7.M11 (GND), U7.M13 (GND), U7.N4 (GND), U7.N8 (GND), U7.N10 (GND), U7.N12 (GND), U7.N14 (GND), U7.P7 (GND), U7.P9 (GND), U7.P11 (GND), U7.P13 (GND), U7.P17 (GND), U7.R8 (GND), U7.R12 (GND), U7.R20 (GND), U7.T3 (GND), U7.T7 (GND), U7.T13 (GND), U7.U6 (GND), U7.U16 (GND), U7.V9 (GND), U7.V19 (GND), U7.W2 (GND), U7.W12 (GND), U7.Y5 (GND), U7.Y15 (GND)
