GusHMeza/Tandem/PWR_main.kicad_sch

## KiCad design PWR_main.kicad_sch (2026-02-01)

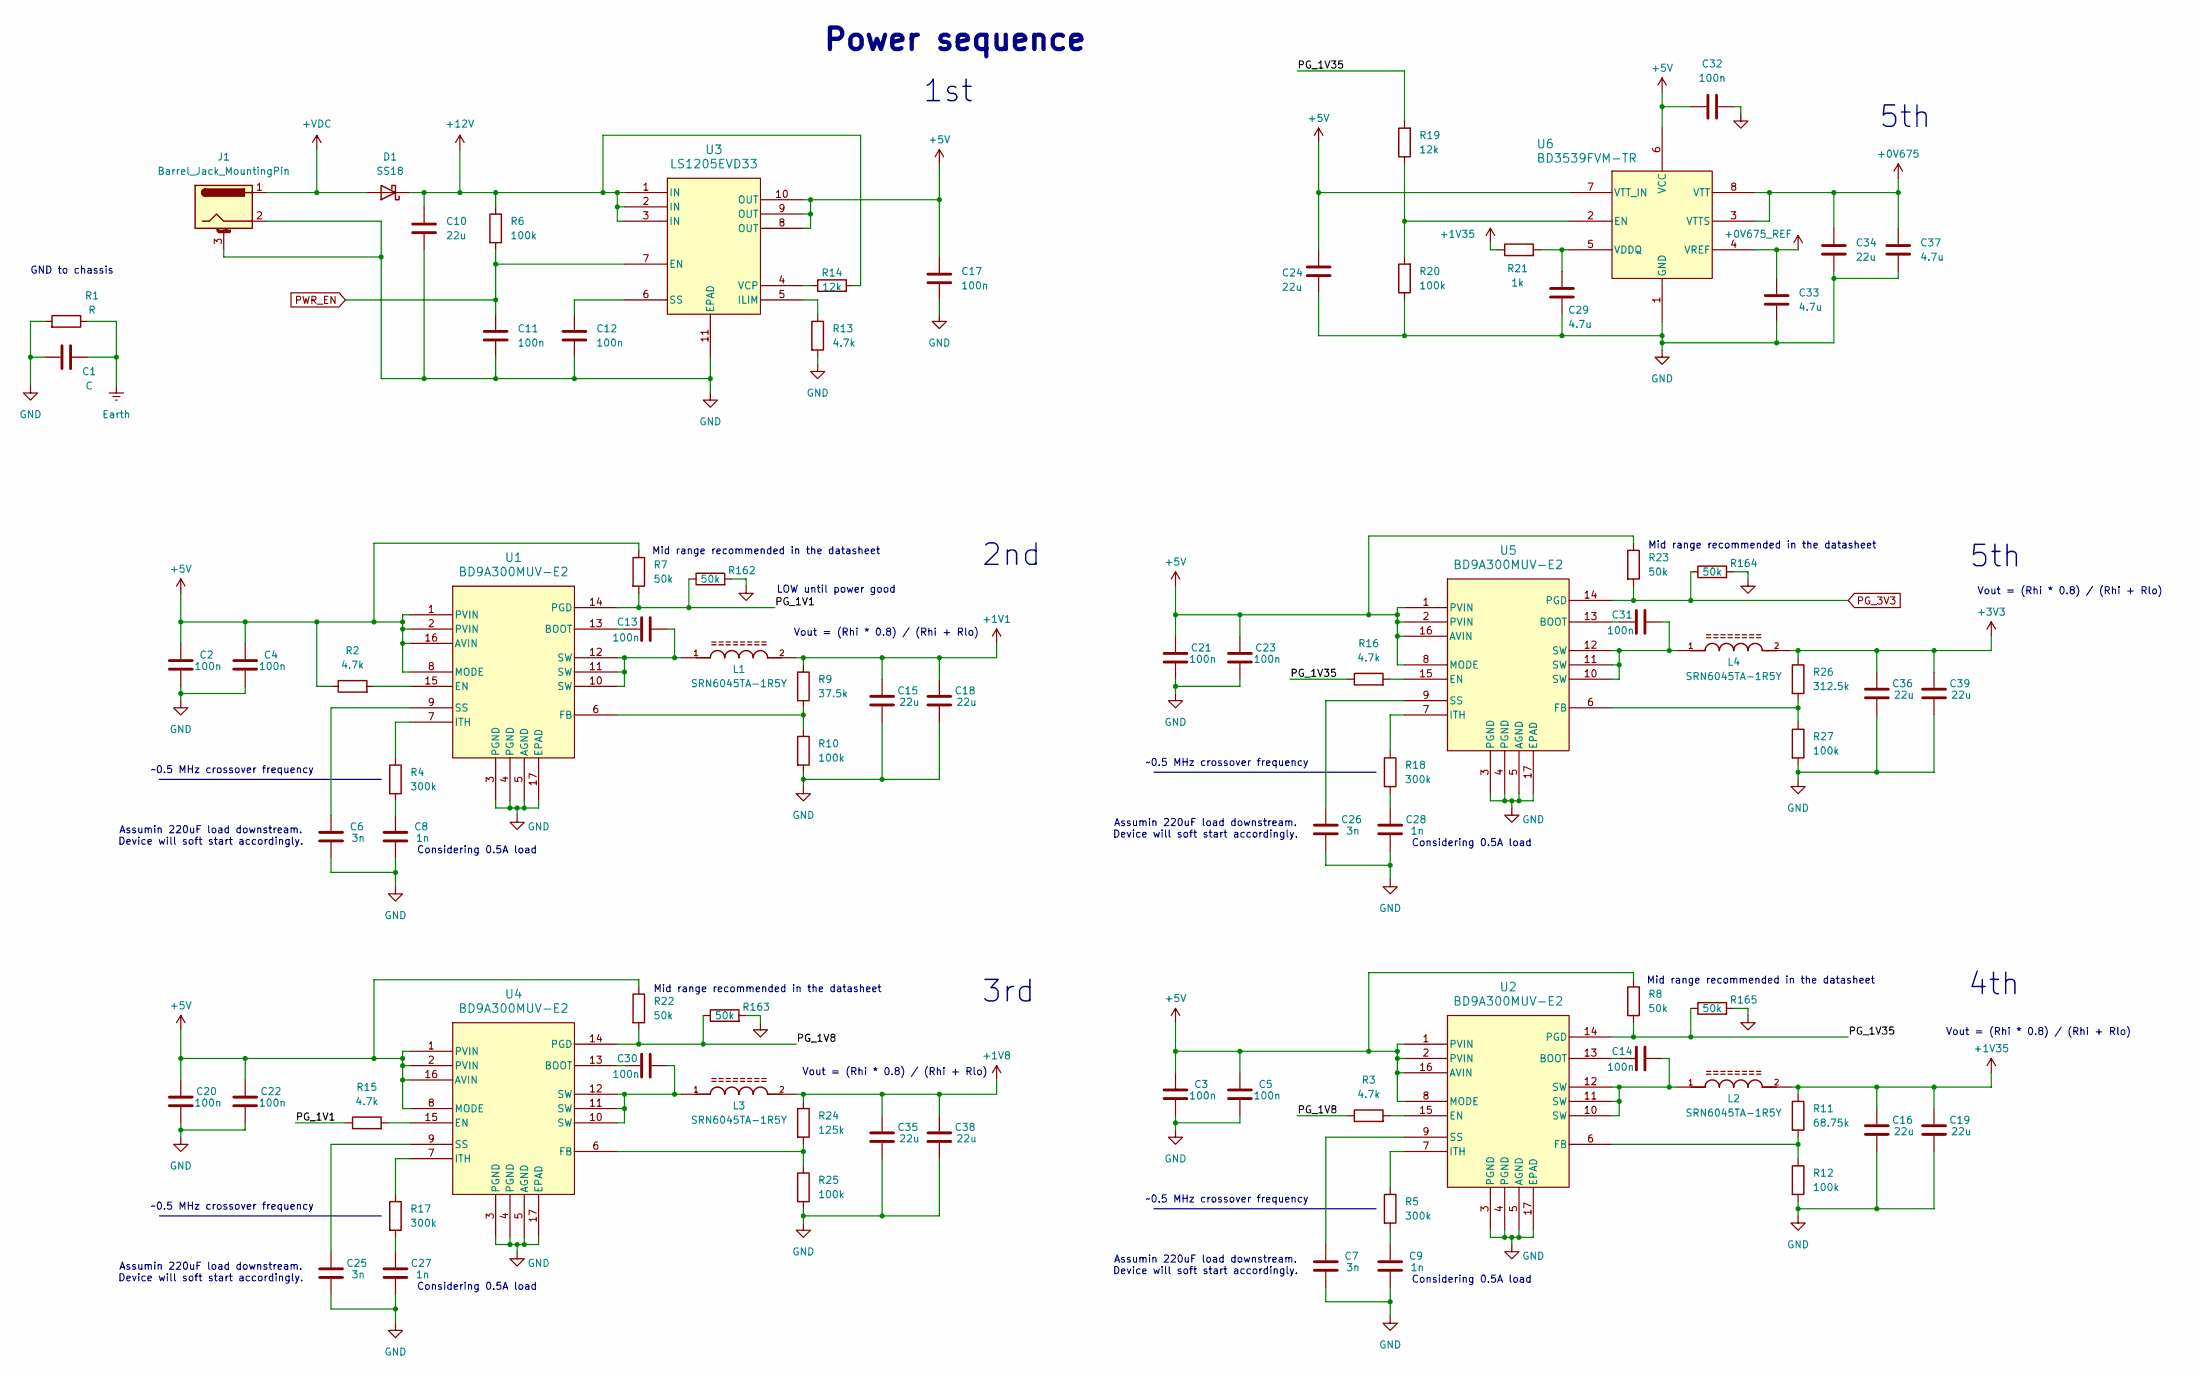
[picture p7: schematic PWR_main.kicad_sch]

Parts:
C1: C; C_0201_0603Metric
C2, C3, C4, C5, C11, C12, C13, C14, C17, C20, C21, C22, C23, C30, C31, C32: 100n; C_0201_0603Metric
C6, C7, C25, C26: 3n; C_0201_0603Metric
C8, C9, C27, C28: 1n; C_0201_0603Metric
C10, C15, C16, C18, C19, C24, C34, C35, C36, C38, C39: 22u; C_0201_0603Metric
C29, C33, C37: 4.7u; C_0201_0603Metric
D1: SS18; D_SMA_Handsoldering
J1: Barrel_Jack_MountingPin; BarrelJack_Horizontal
L1, L2, L3, L4: SRN6045TA-1R5Y; IND_SRN6045TA-1R5Y
R1: R; R_0402_1005Metric_Pad0.72x0.64mm_HandSolder
R2, R3, R13, R15, R16: 4.7k; R_0402_1005Metric_Pad0.72x0.64mm_HandSolder
R4, R5, R17, R18: 300k; R_0402_1005Metric_Pad0.72x0.64mm_HandSolder
R6, R10, R12, R20, R25, R27: 100k; R_0402_1005Metric_Pad0.72x0.64mm_HandSolder
R7, R8, R22, R23, R162, R163, R164, R165: 50k; R_0402_1005Metric_Pad0.72x0.64mm_HandSolder
R9: 37.5k; R_0402_1005Metric_Pad0.72x0.64mm_HandSolder
R11: 68.75k; R_0402_1005Metric_Pad0.72x0.64mm_HandSolder
R14, R19: 12k; R_0402_1005Metric_Pad0.72x0.64mm_HandSolder
R21: 1k; R_0402_1005Metric_Pad0.72x0.64mm_HandSolder
R24: 125k; R_0402_1005Metric_Pad0.72x0.64mm_HandSolder
R26: 312.5k; R_0402_1005Metric_Pad0.72x0.64mm_HandSolder
U1, U2, U4, U5: BD9A300MUV-E2; VQFN016V3030_ROM
U3: LS1205EVD33; DFN10_3x3_LTF
U6: BD3539FVM-TR; MSOP8_ROM

Connections:
+0V675: C34.2, C37.2, U6.3 (VTTS), U6.8 (VTT)
+0V675_REF: C33.2, U6.4 (VREF)
+1V1: C15.2, C18.2, L1.2, R9.1
+1V8: C35.2, C38.2, L3.2, R24.1
+1V35: C16.2, C19.2, L2.2, R11.1, R21.1
+3V3: C36.2, C39.2, L4.2, R26.1
+5V: C2.2, C3.2, C4.2, C5.2, C17.1, C20.2, C21.2, C22.2, C23.2, C24.2, C32.1, R2.1, R7.1, R8.1, R22.1, R23.1, U1.1 (PVIN), U1.2 (PVIN), U1.8 (MODE), U1.16 (AVIN), U2.1 (PVIN), U2.2 (PVIN), U2.8 (MODE), U2.16 (AVIN), U3.8 (OUT), U3.9 (OUT), U3.10 (OUT), U4.1 (PVIN), U4.2 (PVIN), U4.8 (MODE), U4.16 (AVIN), U5.1 (PVIN), U5.2 (PVIN), U5.8 (MODE), U5.16 (AVIN), U6.6 (VCC), U6.7 (VTT_IN)
+12V: C10.1, D1.1 (K), R6.1, R14.2, U3.1 (IN), U3.2 (IN), U3.3 (IN)
+VDC: D1.2 (A), J1.1
Earth: C1.1, R1.1
GND: C1.2, C2.1, C3.1, C4.1, C5.1, C6.1, C7.1, C8.1, C9.1, C10.2, C11.2, C12.2, C15.1, C16.1, C17.2, C18.1, C19.1, C20.1, C21.1, C22.1, C23.1, C24.1, C25.1, C26.1, C27.1, C28.1, C29.1, C32.2, C33.1, C34.1, C35.1, C36.1, C37.1, C38.1, C39.1, J1.2, J1.3 (MountPin), R1.2, R10.2, R12.2, R13.2, R20.1, R25.2, R27.2, R162.2, R163.2, R164.2, R165.2, U1.3 (PGND), U1.4 (PGND), U1.5 (AGND), U1.17 (EPAD), U2.3 (PGND), U2.4 (PGND), U2.5 (AGND), U2.17 (EPAD), U3.11 (EPAD), U4.3 (PGND), U4.4 (PGND), U4.5 (AGND), U4.17 (EPAD), U5.3 (PGND), U5.4 (PGND), U5.5 (AGND), U5.17 (EPAD), U6.1 (GND)
unnamed: C6.2, U1.9 (SS)
unnamed: C7.2, U2.9 (SS)
unnamed: C8.2, R4.2
unnamed: C9.2, R5.2
unnamed: C12.1, U3.6 (SS)
unnamed: C13.1, U1.13 (BOOT)
unnamed: C13.2, L1.1, U1.10 (SW), U1.11 (SW), U1.12 (SW)
unnamed: C14.1, U2.13 (BOOT)
unnamed: C14.2, L2.1, U2.10 (SW), U2.11 (SW), U2.12 (SW)
unnamed: C25.2, U4.9 (SS)
unnamed: C26.2, U5.9 (SS)
unnamed: C27.2, R17.2
unnamed: C28.2, R18.2
unnamed: C29.2, R21.2, U6.5 (VDDQ)
unnamed: C30.1, U4.13 (BOOT)
unnamed: C30.2, L3.1, U4.10 (SW), U4.11 (SW), U4.12 (SW)
unnamed: C31.1, U5.13 (BOOT)
unnamed: C31.2, L4.1, U5.10 (SW), U5.11 (SW), U5.12 (SW)
unnamed: R2.2, U1.15 (EN)
unnamed: R3.2, U2.15 (EN)
unnamed: R4.1, U1.7 (ITH)
unnamed: R5.1, U2.7 (ITH)
unnamed: R9.2, R10.1, U1.6 (FB)
unnamed: R11.2, R12.1, U2.6 (FB)
unnamed: R13.1, U3.5 (ILIM)
unnamed: R14.1, U3.4 (VCP)
unnamed: R15.2, U4.15 (EN)
unnamed: R16.2, U5.15 (EN)
unnamed: R17.1, U4.7 (ITH)
unnamed: R18.1, U5.7 (ITH)
unnamed: R19.1, R20.2, U6.2 (EN)
unnamed: R24.2, R25.1, U4.6 (FB)
unnamed: R26.2, R27.1, U5.6 (FB)
PG_1V1: R7.2, R15.1, R162.1, U1.14 (PGD)
PG_1V8: R3.1, R22.2, R163.1, U4.14 (PGD)
PG_1V35: R8.2, R16.1, R19.2, R165.1, U2.14 (PGD)
PG_3V3: R23.2, R164.1, U5.14 (PGD)
PWR_EN: C11.1, R6.2, U3.7 (EN)

Notes on the sheet:
GND to chassis
4th
Considering 0.5A load
~0.5 MHz crossover frequency
Assumin 220uF load downstream. Device will soft start accordingly.
Vout = (Rhi * 0.8) / (Rhi + Rlo)
1st
LOW until power good
Mid range recommended in the datasheet
5th
Power sequence
2nd
3rd
