GusHMeza/Tandem/Prog_logic.kicad_sch

## KiCad design Prog_logic.kicad_sch (2026-02-01)

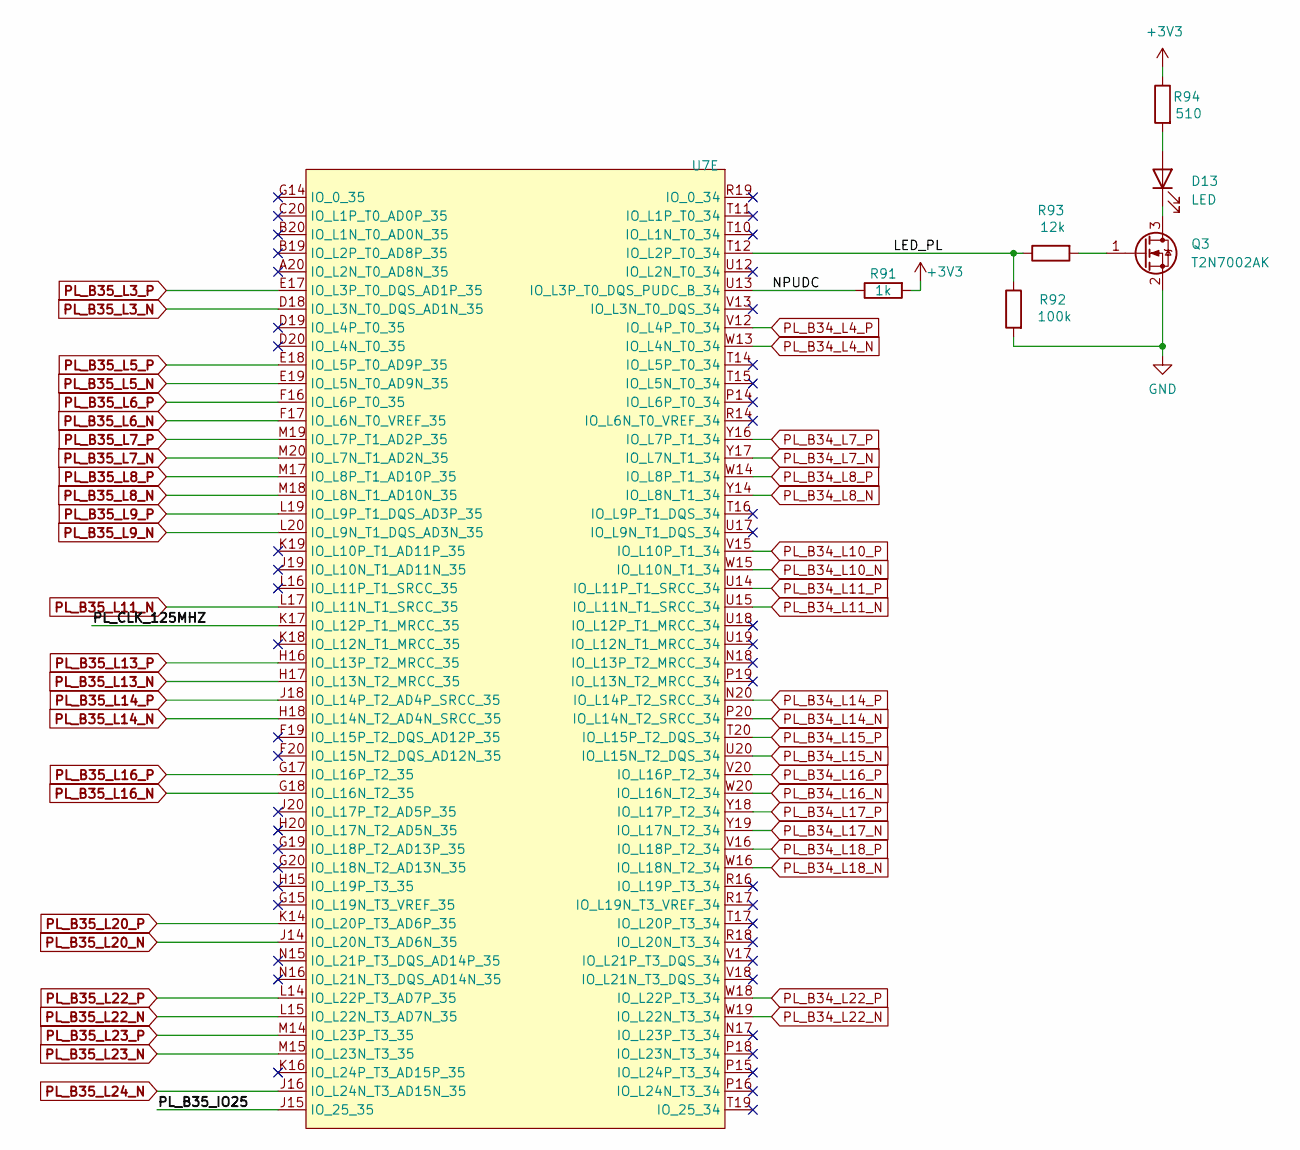
[picture p8: schematic Prog_logic.kicad_sch]

Parts:
D13: LED; LED_0805_2012Metric
Q3: T2N7002AK; SOT-23
R91: 1k; R_0402_1005Metric_Pad0.72x0.64mm_HandSolder
R92: 100k; R_0402_1005Metric_Pad0.72x0.64mm_HandSolder
R93: 12k; R_0402_1005Metric_Pad0.72x0.64mm_HandSolder
R94: 510; R_0402_1005Metric_Pad0.72x0.64mm_HandSolder
U7: Xilinx_CLG400

Connections:
+3V3: R91.2, R94.1
GND: Q3.2 (S), R92.2
LED_PL: R92.1, R93.1, U7.T12 (IO_L2P_T0_34)
NPUDC: R91.1, U7.U13 (IO_L3P_T0_DQS_PUDC_B_34)
unnamed: D13.1 (K), Q3.3 (D)
unnamed: D13.2 (A), R94.2
unnamed: Q3.1 (G), R93.2
PL_B34_L4_N: U7.W13 (IO_L4N_T0_34)
PL_B34_L4_P: U7.V12 (IO_L4P_T0_34)
PL_B34_L7_N: U7.Y17 (IO_L7N_T1_34)
PL_B34_L7_P: U7.Y16 (IO_L7P_T1_34)
PL_B34_L8_N: U7.Y14 (IO_L8N_T1_34)
PL_B34_L8_P: U7.W14 (IO_L8P_T1_34)
PL_B34_L10_N: U7.W15 (IO_L10N_T1_34)
PL_B34_L10_P: U7.V15 (IO_L10P_T1_34)
PL_B34_L11_N: U7.U15 (IO_L11N_T1_SRCC_34)
PL_B34_L11_P: U7.U14 (IO_L11P_T1_SRCC_34)
PL_B34_L14_N: U7.P20 (IO_L14N_T2_SRCC_34)
PL_B34_L14_P: U7.N20 (IO_L14P_T2_SRCC_34)
PL_B34_L15_N: U7.U20 (IO_L15N_T2_DQS_34)
PL_B34_L15_P: U7.T20 (IO_L15P_T2_DQS_34)
PL_B34_L16_N: U7.W20 (IO_L16N_T2_34)
PL_B34_L16_P: U7.V20 (IO_L16P_T2_34)
PL_B34_L17_N: U7.Y19 (IO_L17N_T2_34)
PL_B34_L17_P: U7.Y18 (IO_L17P_T2_34)
PL_B34_L18_N: U7.W16 (IO_L18N_T2_34)
PL_B34_L18_P: U7.V16 (IO_L18P_T2_34)
PL_B34_L22_N: U7.W19 (IO_L22N_T3_34)
PL_B34_L22_P: U7.W18 (IO_L22P_T3_34)
PL_B35_IO25: U7.J15 (IO_25_35)
PL_B35_L3_N: U7.D18 (IO_L3N_T0_DQS_AD1N_35)
PL_B35_L3_P: U7.E17 (IO_L3P_T0_DQS_AD1P_35)
PL_B35_L5_N: U7.E19 (IO_L5N_T0_AD9N_35)
PL_B35_L5_P: U7.E18 (IO_L5P_T0_AD9P_35)
PL_B35_L6_N: U7.F17 (IO_L6N_T0_VREF_35)
PL_B35_L6_P: U7.F16 (IO_L6P_T0_35)
PL_B35_L7_N: U7.M20 (IO_L7N_T1_AD2N_35)
PL_B35_L7_P: U7.M19 (IO_L7P_T1_AD2P_35)
PL_B35_L8_N: U7.M18 (IO_L8N_T1_AD10N_35)
PL_B35_L8_P: U7.M17 (IO_L8P_T1_AD10P_35)
PL_B35_L9_N: U7.L20 (IO_L9N_T1_DQS_AD3N_35)
PL_B35_L9_P: U7.L19 (IO_L9P_T1_DQS_AD3P_35)
PL_B35_L11_N: U7.L17 (IO_L11N_T1_SRCC_35)
PL_B35_L13_N: U7.H17 (IO_L13N_T2_MRCC_35)
PL_B35_L13_P: U7.H16 (IO_L13P_T2_MRCC_35)
PL_B35_L14_N: U7.H18 (IO_L14N_T2_AD4N_SRCC_35)
PL_B35_L14_P: U7.J18 (IO_L14P_T2_AD4P_SRCC_35)
PL_B35_L16_N: U7.G18 (IO_L16N_T2_35)
PL_B35_L16_P: U7.G17 (IO_L16P_T2_35)
PL_B35_L20_N: U7.J14 (IO_L20N_T3_AD6N_35)
PL_B35_L20_P: U7.K14 (IO_L20P_T3_AD6P_35)
PL_B35_L22_N: U7.L15 (IO_L22N_T3_AD7N_35)
PL_B35_L22_P: U7.L14 (IO_L22P_T3_AD7P_35)
PL_B35_L23_N: U7.M15 (IO_L23N_T3_35)
PL_B35_L23_P: U7.M14 (IO_L23P_T3_35)
PL_B35_L24_N: U7.J16 (IO_L24N_T3_AD15N_35)
PL_CLK_125MHZ: U7.K17 (IO_L12P_T1_MRCC_35)
