GusHMeza/Tandem/USB_2_HS.kicad_sch

## KiCad design USB_2_HS.kicad_sch (2026-02-01)

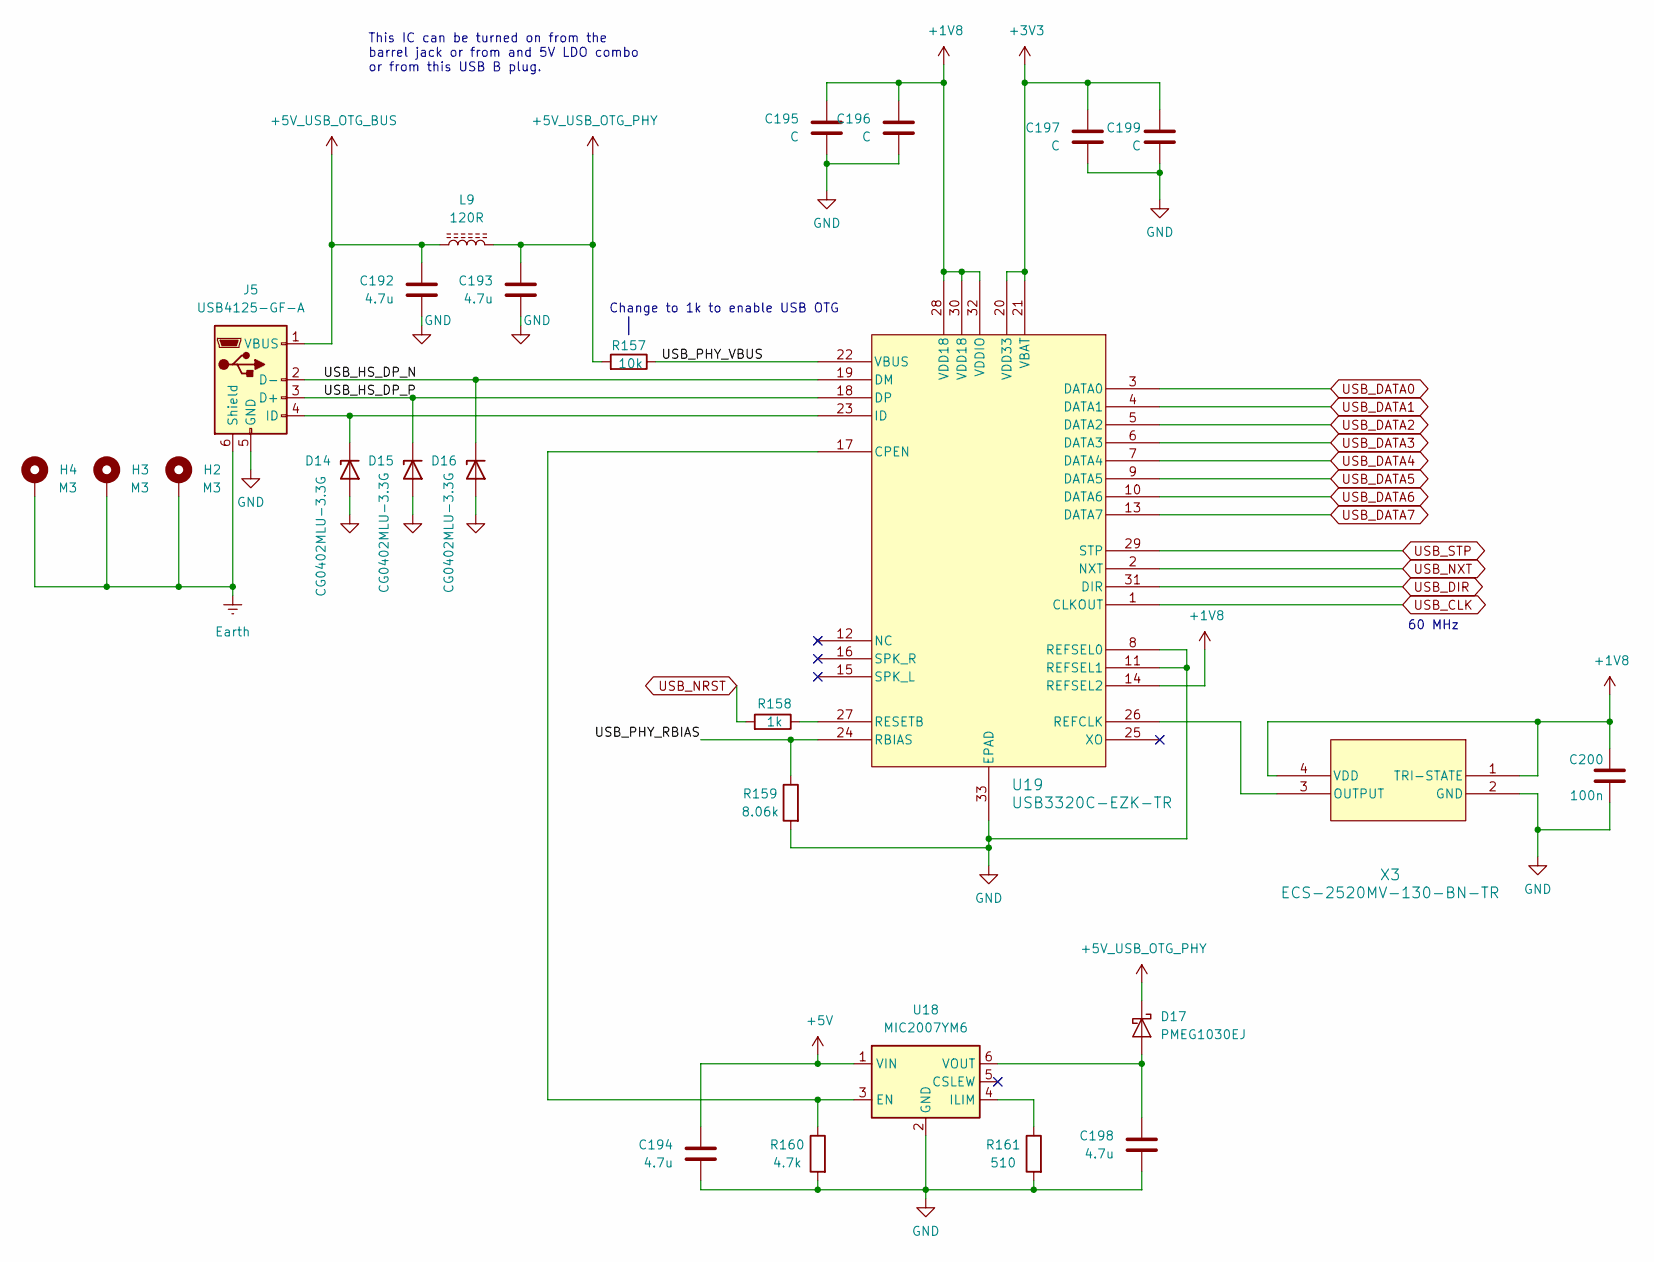
[picture p9: schematic USB_2_HS.kicad_sch]

Parts:
C192, C193, C194, C198: 4.7u; C_0201_0603Metric
C195, C196, C197, C199: C; C_0201_0603Metric
C200: 100n; C_0201_0603Metric
D14, D15, D16: CG0402MLU-3.3G; D_0402_1005Metric
D17: PMEG1030EJ; D_SOD-323F
H2, H3, H4: M3; MountingHole_2.7mm_M2.5_DIN965_Pad
J5: USB4125-GF-A; USB_Mini-B_Lumberg_2486_01_Horizontal
L9: 120R; L_0402_1005Metric
R157: 10k; R_0402_1005Metric_Pad0.72x0.64mm_HandSolder
R158: 1k; R_0402_1005Metric_Pad0.72x0.64mm_HandSolder
R159: 8.06k; R_0402_1005Metric_Pad0.72x0.64mm_HandSolder
R160: 4.7k; R_0402_1005Metric_Pad0.72x0.64mm_HandSolder
R161: 510; R_0402_1005Metric_Pad0.72x0.64mm_HandSolder
U18: MIC2007YM6; SOT-23-6
U19: USB3320C-EZK-TR; QFN32_5X5MC_MCH
X3: ECS-2520MV-130-BN-TR; SMD4_ECS-2520MV_ECS

Connections:
+1V8: C195.1, C196.1, C200.1, U19.14 (REFSEL2), U19.28 (VDD18), U19.30 (VDD18), U19.32 (VDDIO), X3.1 (TRI-STATE), X3.4 (VDD)
+3V3: C197.1, C199.1, U19.20 (VDD33), U19.21 (VBAT)
+5V: C194.1, U18.1 (VIN)
+5V_USB_OTG_BUS: C192.1, J5.1 (VBUS), L9.2
+5V_USB_OTG_PHY: C193.1, D17.1 (K), L9.1, R157.2
Earth: H2.1, H3.1, H4.1, J5.6 (Shield)
GND: C192.2, C193.2, C194.2, C195.2, C196.2, C197.2, C198.2, C199.2, C200.2, D14.2 (A), D15.2 (A), D16.2 (A), J5.5 (GND), R159.2, R160.2, R161.2, U18.2 (GND), U19.8 (REFSEL0), U19.11 (REFSEL1), U19.33 (EPAD), X3.2 (GND)
unnamed: C198.1, D17.2 (A), U18.6 (VOUT)
unnamed: D14.1 (K), J5.4 (ID), U19.23 (ID)
unnamed: R158.1, U19.27 (RESETB)
unnamed: R160.1, U18.3 (EN), U19.17 (CPEN)
unnamed: R161.1, U18.4 (ILIM)
unnamed: U19.26 (REFCLK), X3.3 (OUTPUT)
USB_CLK: U19.1 (CLKOUT)
USB_DATA0: U19.3 (DATA0)
USB_DATA1: U19.4 (DATA1)
USB_DATA2: U19.5 (DATA2)
USB_DATA3: U19.6 (DATA3)
USB_DATA4: U19.7 (DATA4)
USB_DATA5: U19.9 (DATA5)
USB_DATA6: U19.10 (DATA6)
USB_DATA7: U19.13 (DATA7)
USB_DIR: U19.31 (DIR)
USB_HS_DP_N: D16.1 (K), J5.2 (D-), U19.19 (DM)
USB_HS_DP_P: D15.1 (K), J5.3 (D+), U19.18 (DP)
USB_NRST: R158.2
USB_NXT: U19.2 (NXT)
USB_PHY_RBIAS: R159.1, U19.24 (RBIAS)
USB_PHY_VBUS: R157.1, U19.22 (VBUS)
USB_STP: U19.29 (STP)

Notes on the sheet:
Change to 1k to enable USB OTG
60 MHz
This IC can be turned on from the barrel jack or from and 5V LDO combo or from this USB B plug.
