GusHMeza/Tandem/sims.kicad_sch

## KiCad design sims.kicad_sch (2026-02-01)

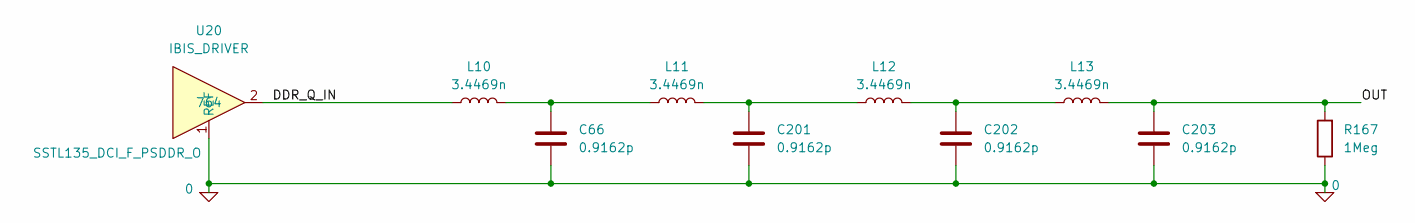
[picture p10: schematic sims.kicad_sch]

Parts:
C66, C201, C202, C203: 0.9162p
L10, L11, L12, L13: 3.4469n
R167: 1Meg
U20: IBIS_DRIVER

Connections:
0: C66.2, C201.2, C202.2, C203.2, R167.1, U20.1 (REF)
DDR_Q_IN: L10.1, U20.2
unnamed: C66.1, L10.2, L11.1
unnamed: C201.1, L11.2, L12.1
unnamed: C202.1, L12.2, L13.1
OUT: C203.1, L13.2, R167.2
