GusHMeza/Tandem/uP.kicad_sch

## KiCad design uP.kicad_sch (2026-02-01)

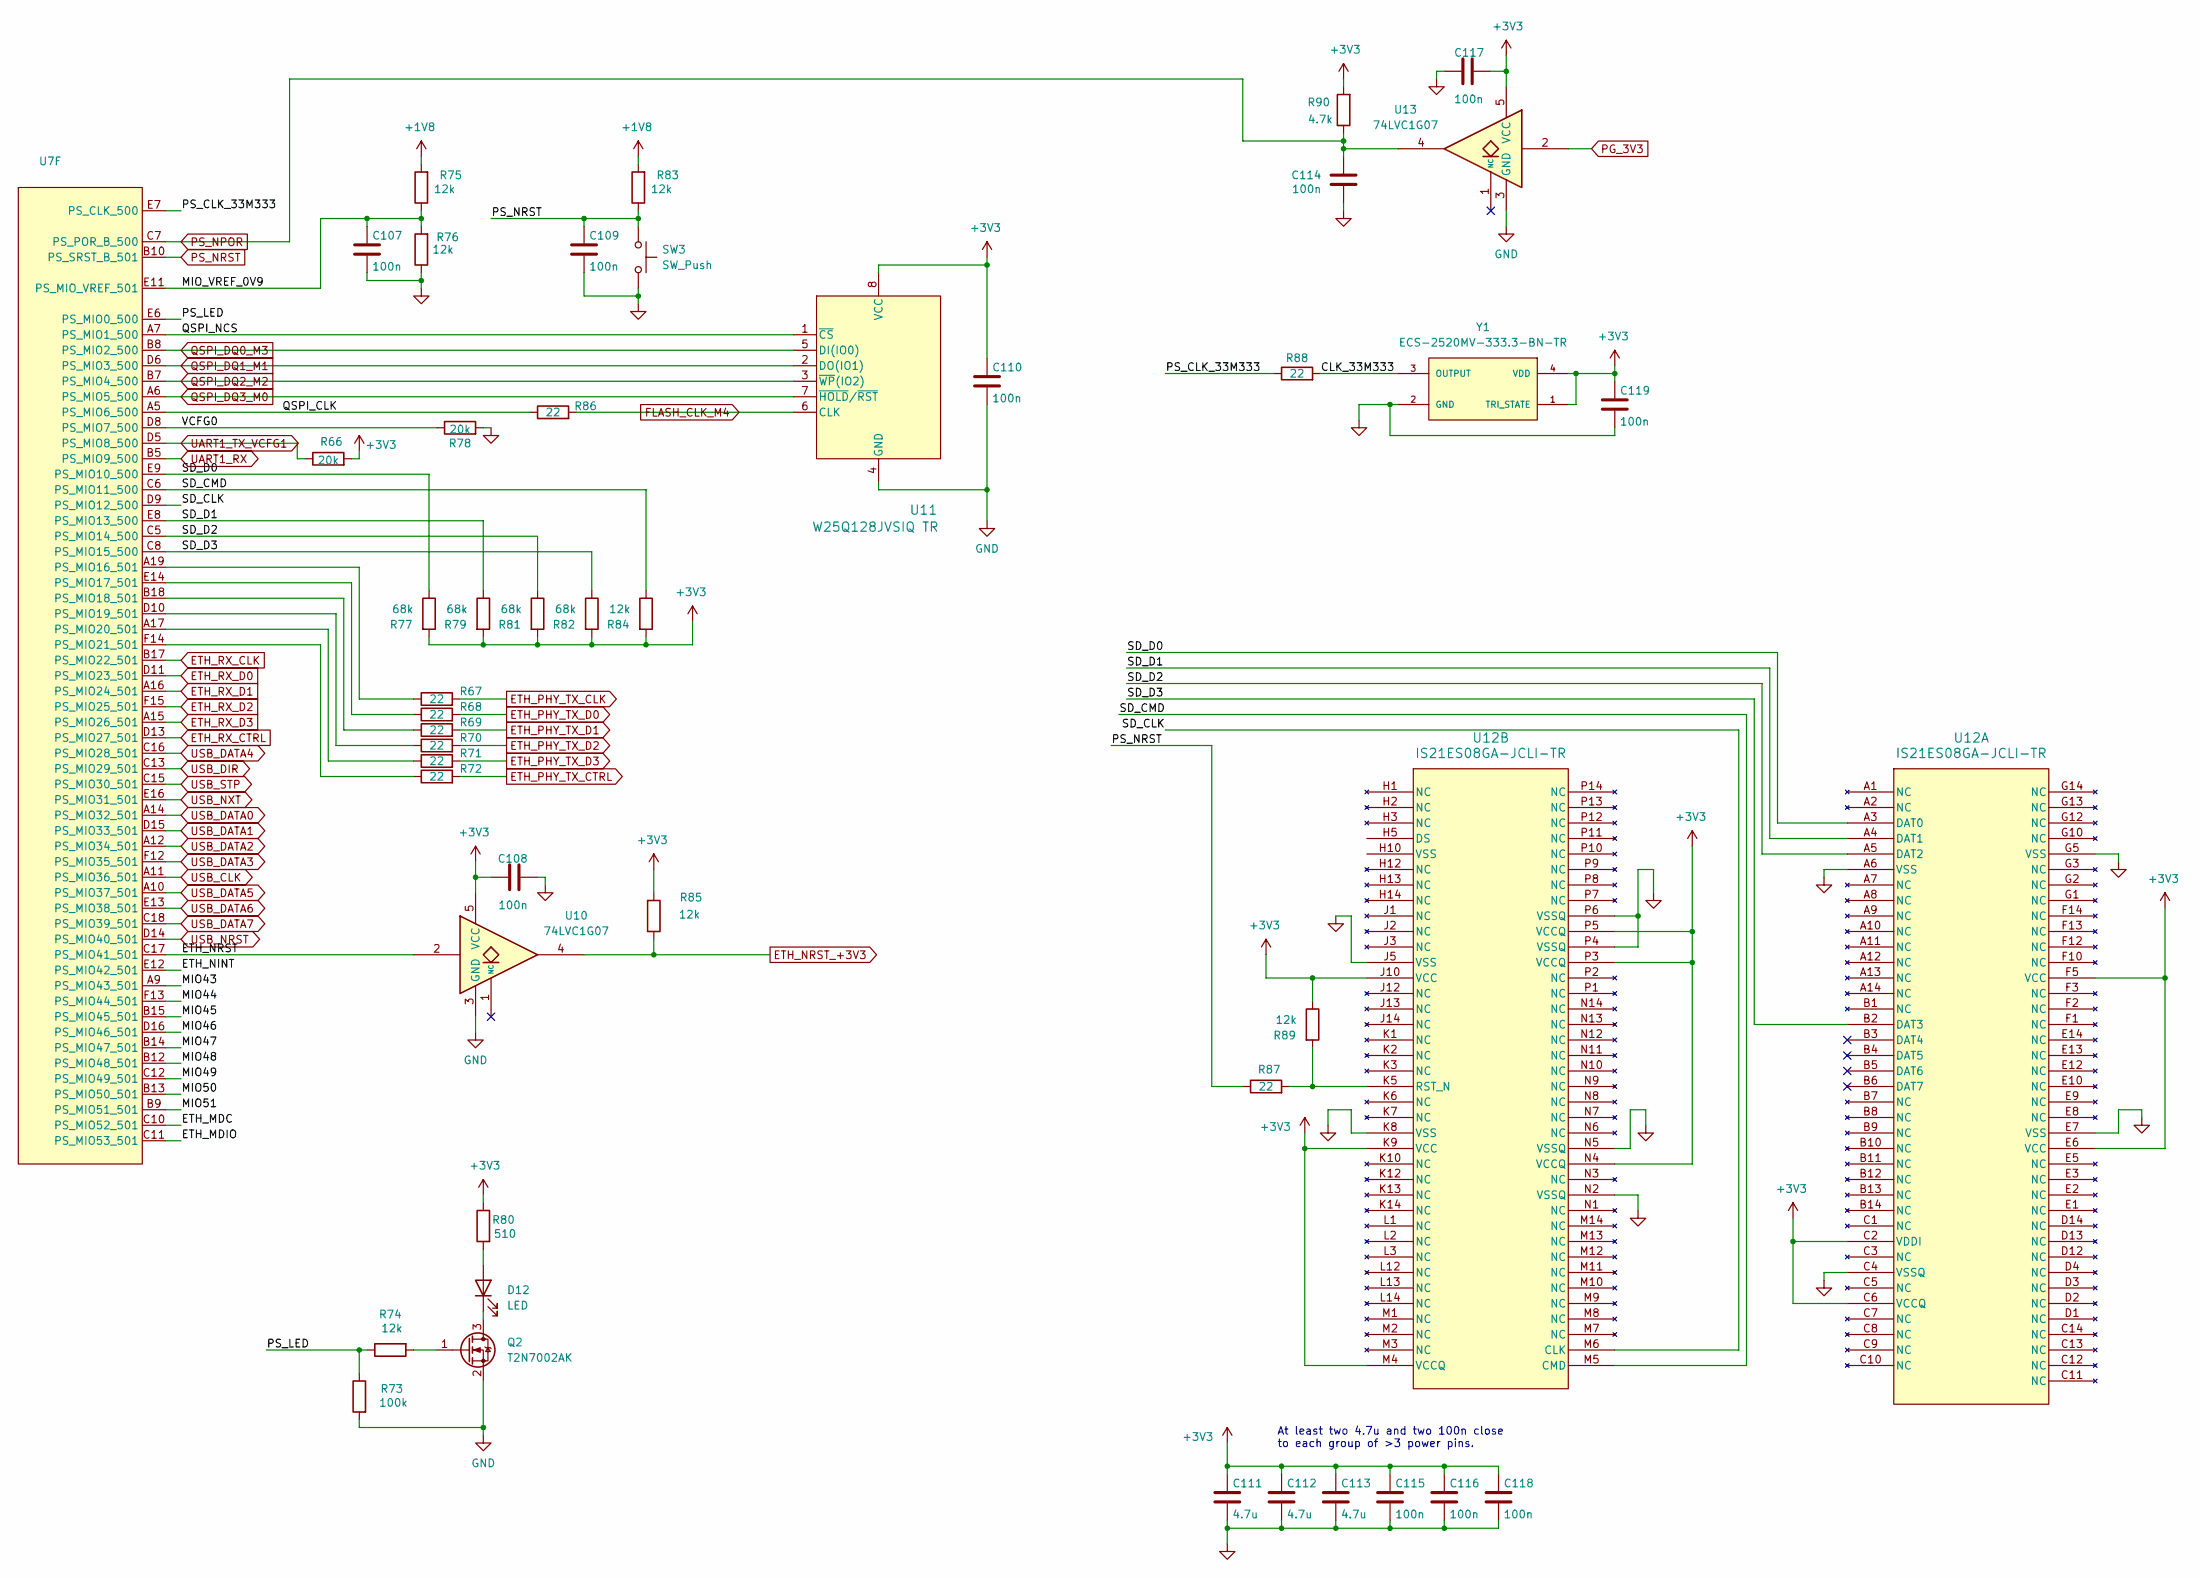
[picture p11: schematic uP.kicad_sch]

Parts:
C107, C108, C109, C110, C114, C115, C116, C117, C118, C119: 100n; C_0201_0603Metric
C111, C112, C113: 4.7u; C_0201_0603Metric
D12: LED; LED_0805_2012Metric
Q2: T2N7002AK; SOT-23
R66, R78: 20k; R_0402_1005Metric_Pad0.72x0.64mm_HandSolder
R67, R68, R69, R70, R71, R72, R86, R87, R88: 22; R_0402_1005Metric_Pad0.72x0.64mm_HandSolder
R73: 100k; R_0402_1005Metric_Pad0.72x0.64mm_HandSolder
R74, R75, R76, R83, R84, R85, R89: 12k; R_0402_1005Metric_Pad0.72x0.64mm_HandSolder
R77, R79, R81, R82: 68k; R_0402_1005Metric_Pad0.72x0.64mm_HandSolder
R80: 510; R_0402_1005Metric_Pad0.72x0.64mm_HandSolder
R90: 4.7k; R_0402_1005Metric_Pad0.72x0.64mm_HandSolder
SW3: SW_Push; PTS910
U7: Xilinx_CLG400
U10, U13: 74LVC1G07; SOT-23-5
U11: W25Q128JVSIQ TR; SOIC_208MIL_WIN
U12: IS21ES08GA-JCLI-TR; FBGA153_ISI
Y1: ECS-2520MV-333.3-BN-TR; OSC_ECS-2520S25-250-FN-TR

Connections:
+1V8: R75.2, R83.2
+3V3: C108.1, C110.1, C111.1, C112.1, C113.1, C115.1, C116.1, C117.1, C118.1, C119.1, R66.2, R77.2, R79.2, R80.1, R81.2, R82.2, R84.2, R85.2, R89.1, R90.2, U10.5 (VCC), U11.8 (VCC), U12.C2 (VDDI), U12.C6 (VCCQ), U12.E6 (VCC), U12.F5 (VCC), U12.J10 (VCC), U12.K9 (VCC), U12.M4 (VCCQ), U12.N4 (VCCQ), U12.P3 (VCCQ), U12.P5 (VCCQ), U13.5 (VCC), Y1.1 (TRI_STATE), Y1.4 (VDD)
CLK_33M333: R88.2, Y1.3 (OUTPUT)
ETH_MDC: U7.C10 (PS_MIO52_501)
ETH_MDIO: U7.C11 (PS_MIO53_501)
ETH_NINT: U7.E12 (PS_MIO42_501)
ETH_NRST: U7.C17 (PS_MIO41_501), U10.2
ETH_NRST_+3V3: R85.1, U10.4
ETH_PHY_TX_CLK: R67.2
ETH_PHY_TX_CTRL: R72.2
ETH_PHY_TX_D0: R68.2
ETH_PHY_TX_D1: R69.2
ETH_PHY_TX_D2: R70.2
ETH_PHY_TX_D3: R71.2
ETH_RX_CLK: U7.B17 (PS_MIO22_501)
ETH_RX_CTRL: U7.D13 (PS_MIO27_501)
ETH_RX_D0: U7.D11 (PS_MIO23_501)
ETH_RX_D1: U7.A16 (PS_MIO24_501)
ETH_RX_D2: U7.F15 (PS_MIO25_501)
ETH_RX_D3: U7.A15 (PS_MIO26_501)
FLASH_CLK_M4: R86.2, U11.6 (CLK)
GND: C107.2, C108.2, C109.2, C110.2, C111.2, C112.2, C113.2, C114.2, C115.2, C116.2, C117.2, C118.2, C119.2, Q2.2 (S), R73.2, R76.1, R78.2, SW3.2, U10.3 (GND), U11.4 (GND), U12.A6 (VSS), U12.C4 (VSSQ), U12.E7 (VSS), U12.G5 (VSS), U12.J5 (VSS), U12.K8 (VSS), U12.N2 (VSSQ), U12.N5 (VSSQ), U12.P4 (VSSQ), U12.P6 (VSSQ), U13.3 (GND), Y1.2 (GND)
MIO43: U7.A9 (PS_MIO43_501)
MIO44: U7.F13 (PS_MIO44_501)
MIO45: U7.B15 (PS_MIO45_501)
MIO46: U7.D16 (PS_MIO46_501)
MIO47: U7.B14 (PS_MIO47_501)
MIO48: U7.B12 (PS_MIO48_501)
MIO49: U7.C12 (PS_MIO49_501)
MIO50: U7.B13 (PS_MIO50_501)
MIO51: U7.B9 (PS_MIO51_501)
MIO_VREF_0V9: C107.1, R75.1, R76.2, U7.E11 (PS_MIO_VREF_501)
unnamed: D12.1 (K), Q2.3 (D)
unnamed: D12.2 (A), R80.2
unnamed: Q2.1 (G), R74.2
unnamed: R67.1, U7.A19 (PS_MIO16_501)
unnamed: R68.1, U7.E14 (PS_MIO17_501)
unnamed: R69.1, U7.B18 (PS_MIO18_501)
unnamed: R70.1, U7.D10 (PS_MIO19_501)
unnamed: R71.1, U7.A17 (PS_MIO20_501)
unnamed: R72.1, U7.F14 (PS_MIO21_501)
unnamed: R87.2, R89.2, U12.K5 (RST_N)
PG_3V3: U13.2
PS_CLK_33M333: R88.1, U7.E7 (PS_CLK_500)
PS_LED: R73.1, R74.1, U7.E6 (PS_MIO0_500)
PS_NPOR: C114.1, R90.1, U7.C7 (PS_POR_B_500), U13.4
PS_NRST: C109.1, R83.1, R87.1, SW3.1, U7.B10 (PS_SRST_B_501)
QSPI_CLK: R86.1, U7.A5 (PS_MIO6_500)
QSPI_DQ0_M3: U7.B8 (PS_MIO2_500), U11.5 (DI(IO0))
QSPI_DQ1_M1: U7.D6 (PS_MIO3_500), U11.2 (DO(IO1))
QSPI_DQ2_M2: U7.B7 (PS_MIO4_500), U11.3 (~WP(IO2))
QSPI_DQ3_M0: U7.A6 (PS_MIO5_500), U11.7 (~HOLD/~RST)
QSPI_NCS: U7.A7 (PS_MIO1_500), U11.1 (~CS)
SD_CLK: U7.D9 (PS_MIO12_500), U12.M6 (CLK)
SD_CMD: R84.1, U7.C6 (PS_MIO11_500), U12.M5 (CMD)
SD_D0: R77.1, U7.E9 (PS_MIO10_500), U12.A3 (DAT0)
SD_D1: R79.1, U7.E8 (PS_MIO13_500), U12.A4 (DAT1)
SD_D2: R81.1, U7.C5 (PS_MIO14_500), U12.A5 (DAT2)
SD_D3: R82.1, U7.C8 (PS_MIO15_500), U12.B2 (DAT3)
UART1_RX: U7.B5 (PS_MIO9_500)
UART1_TX_VCFG1: R66.1, U7.D5 (PS_MIO8_500)
USB_CLK: U7.A11 (PS_MIO36_501)
USB_DATA0: U7.A14 (PS_MIO32_501)
USB_DATA1: U7.D15 (PS_MIO33_501)
USB_DATA2: U7.A12 (PS_MIO34_501)
USB_DATA3: U7.F12 (PS_MIO35_501)
USB_DATA4: U7.C16 (PS_MIO28_501)
USB_DATA5: U7.A10 (PS_MIO37_501)
USB_DATA6: U7.E13 (PS_MIO38_501)
USB_DATA7: U7.C18 (PS_MIO39_501)
USB_DIR: U7.C13 (PS_MIO29_501)
USB_NRST: U7.D14 (PS_MIO40_501)
USB_NXT: U7.E16 (PS_MIO31_501)
USB_STP: U7.C15 (PS_MIO30_501)
VCFG0: R78.1, U7.D8 (PS_MIO7_500)

Notes on the sheet:
At least two 4.7u and two 100n close to each group of >3 power pins.
