GusHMeza/Tandem/untitled.kicad_sch

## KiCad design untitled.kicad_sch (2026-02-01)

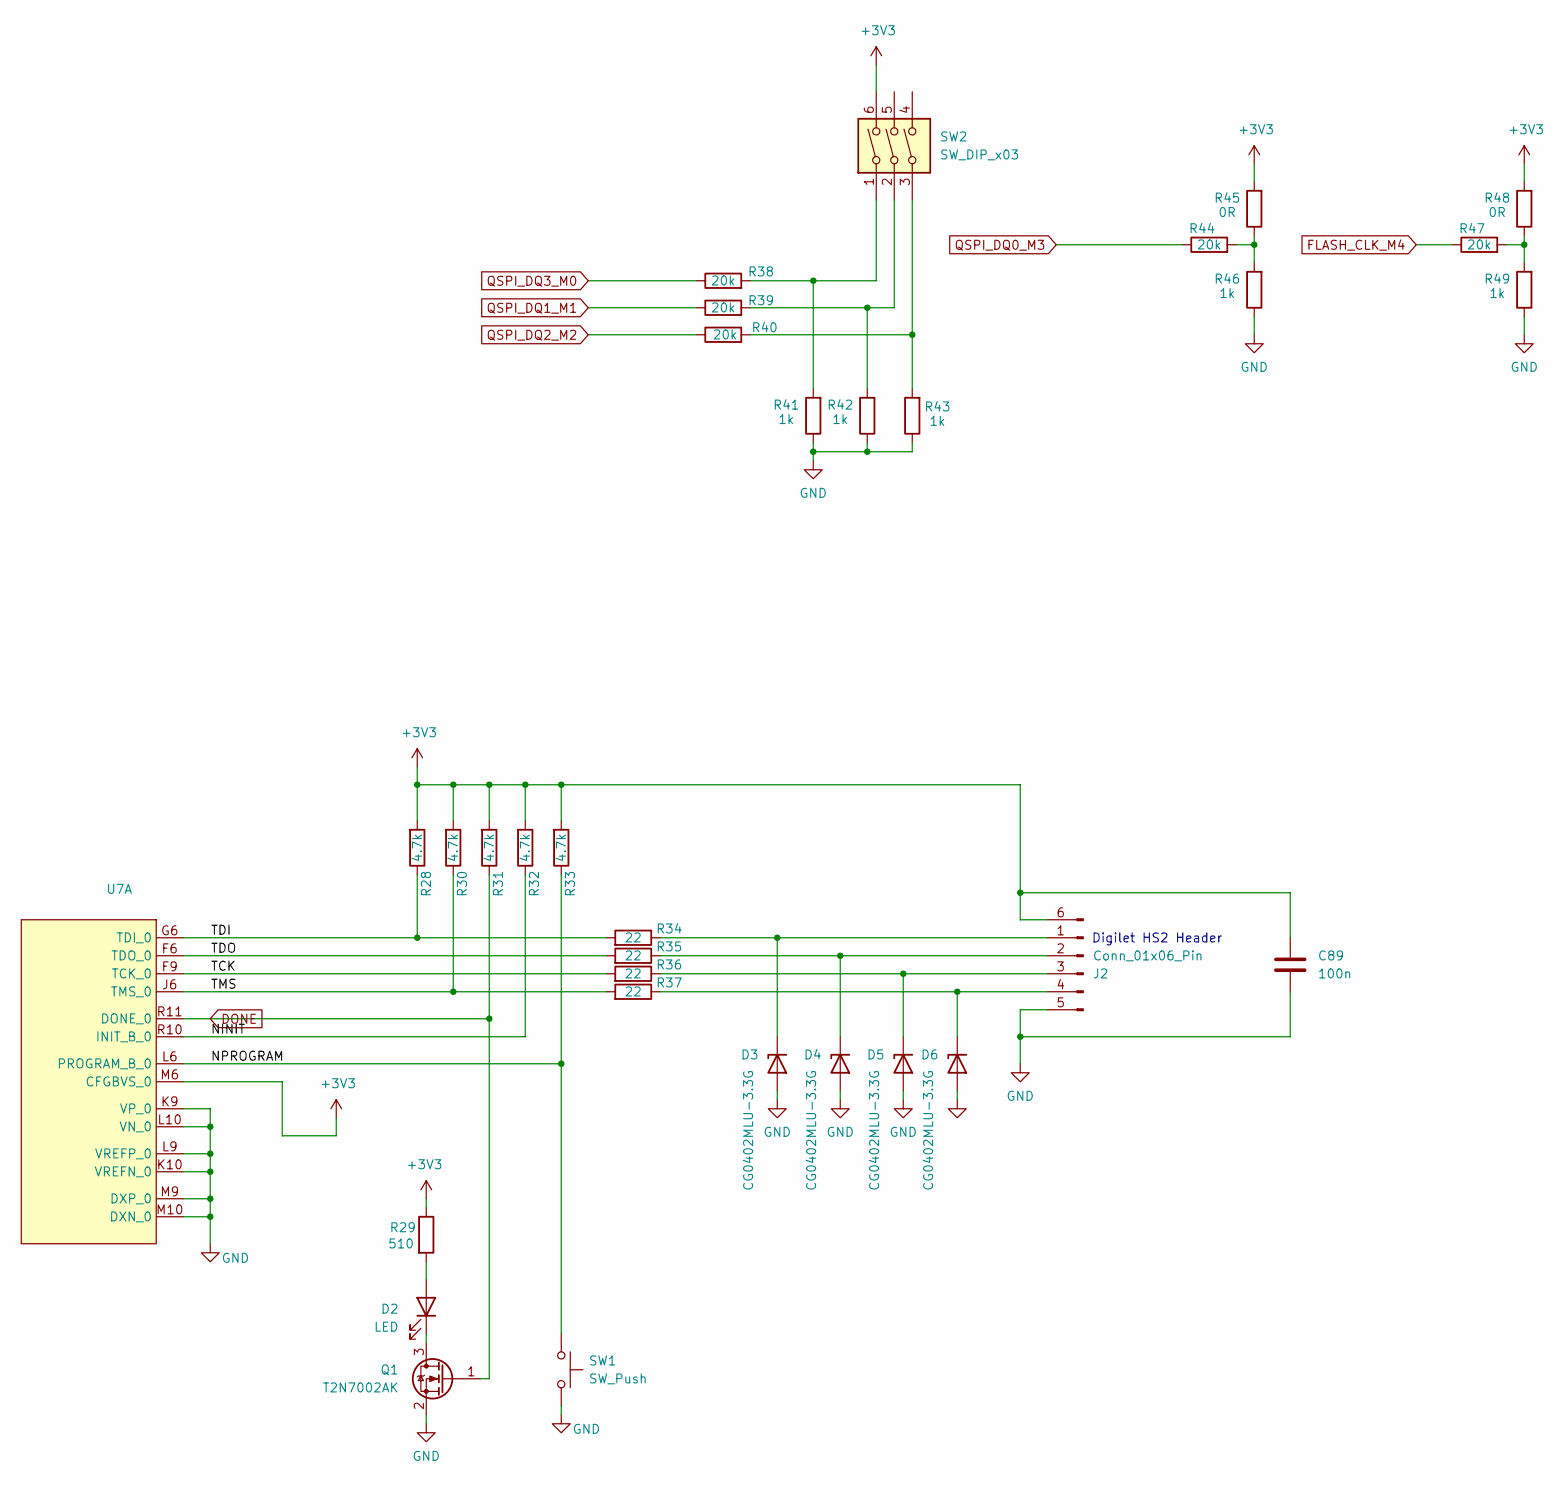
[picture p12: schematic untitled.kicad_sch]

Parts:
C89: 100n; C_0201_0603Metric
D2: LED; LED_0805_2012Metric
D3, D4, D5, D6: CG0402MLU-3.3G; D_0402_1005Metric
J2: Conn_01x06_Pin; PinHeader_1x06_P2.54mm_Vertical
Q1: T2N7002AK; SOT-23
R28, R30, R31, R32, R33: 4.7k; R_0402_1005Metric_Pad0.72x0.64mm_HandSolder
R29: 510; R_0402_1005Metric_Pad0.72x0.64mm_HandSolder
R34, R35, R36, R37: 22; R_0402_1005Metric_Pad0.72x0.64mm_HandSolder
R38, R39, R40, R44, R47: 20k; R_0402_1005Metric_Pad0.72x0.64mm_HandSolder
R41, R42, R43, R46, R49: 1k; R_0402_1005Metric_Pad0.72x0.64mm_HandSolder
R45, R48: 0R; R_0402_1005Metric_Pad0.72x0.64mm_HandSolder
SW1: SW_Push; PTS910
SW2: SW_DIP_x03; SW_DIP_SPSTx03_Slide_6.7x9.18mm_W6.73mm_P2.54mm_LowProfile_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
U7: Xilinx_CLG400

Connections:
+3V3: C89.1, J2.6, R28.2, R29.1, R30.2, R31.2, R32.2, R33.2, R45.2, R48.2, SW2.6, U7.M6 (CFGBVS_0)
DONE: Q1.1 (G), R31.1, U7.R11 (DONE_0)
FLASH_CLK_M4: R47.1
GND: C89.2, D3.2 (A), D4.2 (A), D5.2 (A), D6.2 (A), J2.5, Q1.2 (S), R41.1, R42.1, R43.1, R46.1, R49.1, SW1.2, U7.K9 (VP_0), U7.K10 (VREFN_0), U7.L9 (VREFP_0), U7.L10 (VN_0), U7.M9 (DXP_0), U7.M10 (DXN_0)
NINIT: R32.1, U7.R10 (INIT_B_0)
NPROGRAM: R33.1, SW1.1, U7.L6 (PROGRAM_B_0)
unnamed: D2.1 (K), Q1.3 (D)
unnamed: D2.2 (A), R29.2
unnamed: D3.1 (K), J2.1, R34.1
unnamed: D4.1 (K), J2.2, R35.1
unnamed: D5.1 (K), J2.3, R36.1
unnamed: D6.1 (K), J2.4, R37.1
unnamed: R38.2, R41.2, SW2.1
unnamed: R39.2, R42.2, SW2.2
unnamed: R40.2, R43.2, SW2.3
unnamed: R44.2, R45.1, R46.2
unnamed: R47.2, R48.1, R49.2
QSPI_DQ0_M3: R44.1
QSPI_DQ1_M1: R39.1
QSPI_DQ2_M2: R40.1
QSPI_DQ3_M0: R38.1
TCK: R36.2, U7.F9 (TCK_0)
TDI: R28.1, R34.2, U7.G6 (TDI_0)
TDO: R35.2, U7.F6 (TDO_0)
TMS: R30.1, R37.2, U7.J6 (TMS_0)

Notes on the sheet:
Digilet HS2 Header
