GusHMeza/Tandem/(commit log)

2026-02-01 Add rev A KiCAD files via upload
    [ADHW.kicad_sch, Conf_Jtag_Dbg.kicad_sch, DDR3_block.kicad_sch, DDR_term.kicad_sch, GB_Eth.kicad_sch, Mezz_Conns.kicad_sch, PWR_and_caps.kicad_sch, PWR_main.kicad_sch]
2026-02-01 Add misc KiCAD files
